fuad1502/open-running-watch-hw/models/1-2328702-0/3D/1-2328702-0.stp

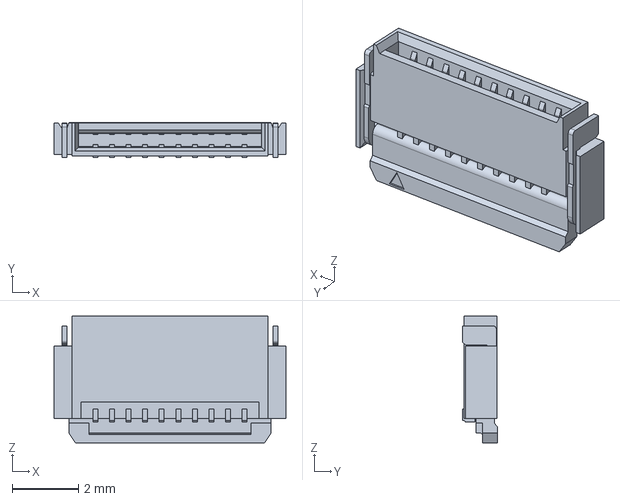
[picture p3: CAD file, 2024-04-13]
models/1-2328702-0/3D/1-2328702-0.stp
7.00 x 1.06 x 3.83 mm
