fuad1502/open-running-watch-hw/models/5029/3D/5029.stp

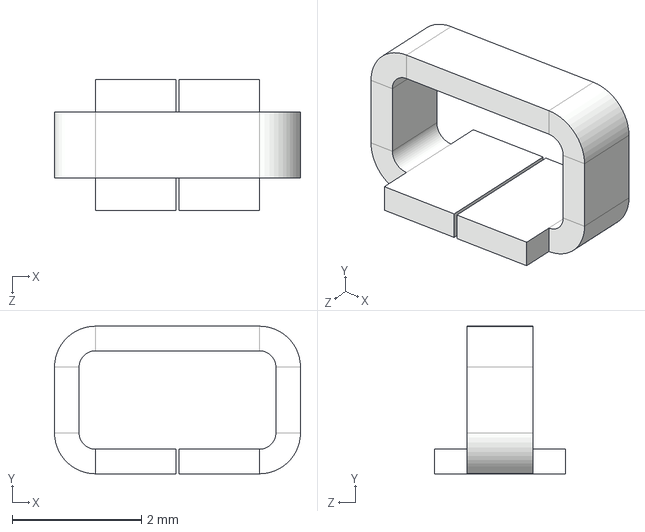
[picture p4: CAD file, 2024-04-12]
models/5029/3D/5029.stp
3.81 x 2.29 x 2.03 mm
