fuad1502/open-running-watch-hw/models/BALF-NRG-02D3/3D/BALF-NRG-02D3.stp

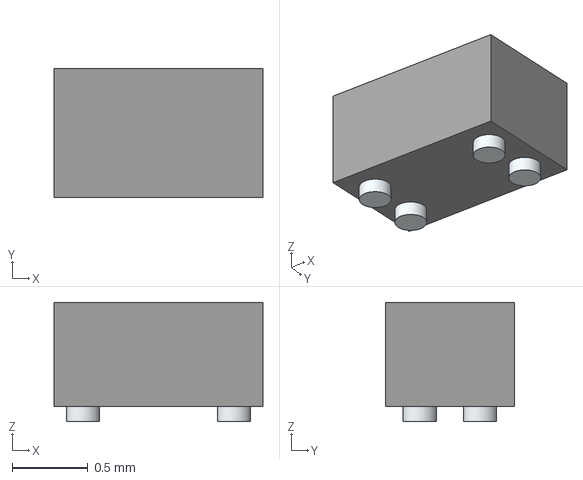
[picture p5: CAD file, 2024-04-12]
models/BALF-NRG-02D3/3D/BALF-NRG-02D3.stp
1.38 x 0.855 x 0.79 mm
Pins
