fuad1502/open-running-watch-hw/models/BAS16LT3G/3D/BAS16LT3G.stp

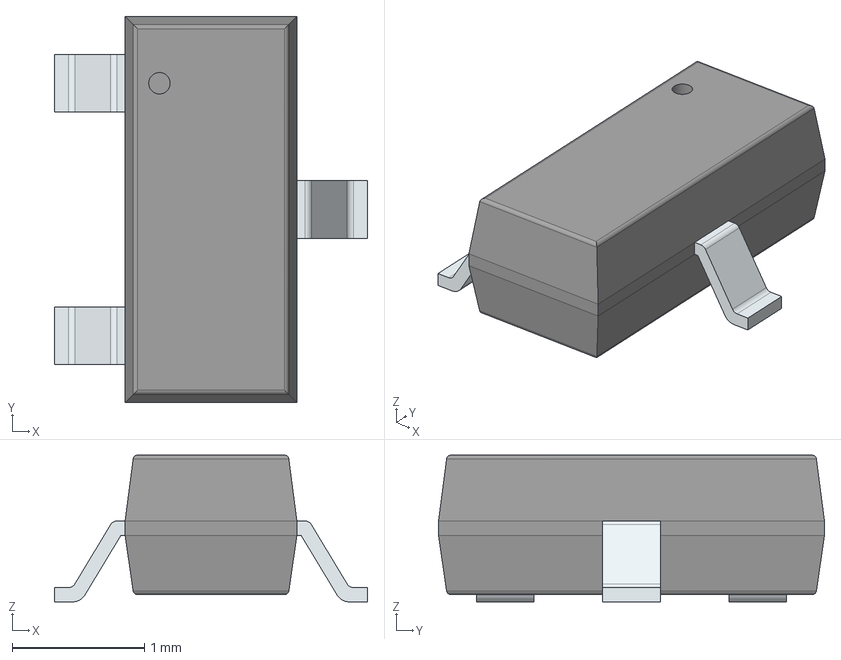
[picture p6: CAD file, 2024-04-12]
models/BAS16LT3G/3D/BAS16LT3G.stp
2.37 x 2.92 x 1.11 mm
PinsArrayL
FilletPinR
