fuad1502/open-running-watch-hw/models/BC817-25-QVL/3D/BC817-25-QVL.stp

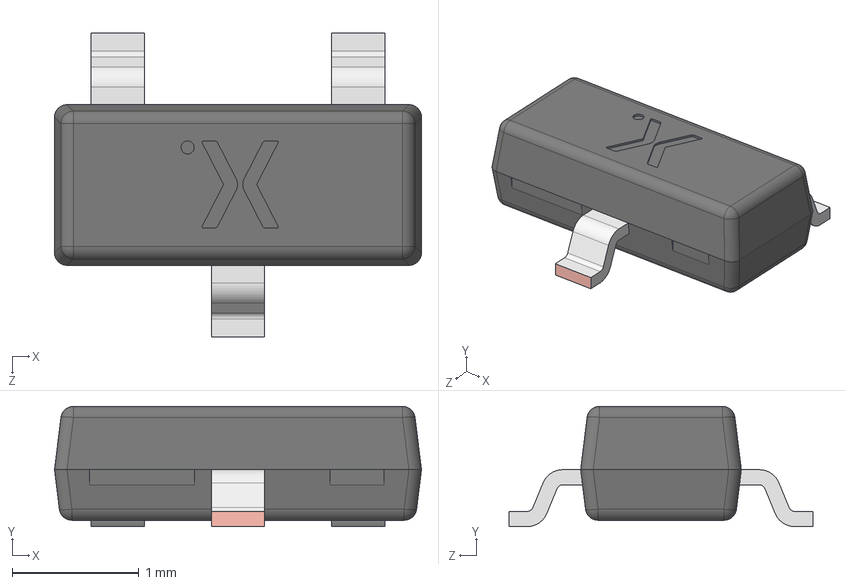
[picture p7: CAD file, 2024-04-12]
models/BC817-25-QVL/3D/BC817-25-QVL.stp
2.90 x 0.95 x 2.40 mm
SOT23 lower body
SOT23 Lead x 3
SOT23 Upper body
