fuad1502/open-running-watch-hw/models/BGA_725L6_E6327/3D/BGA_725L6_E6327.stp

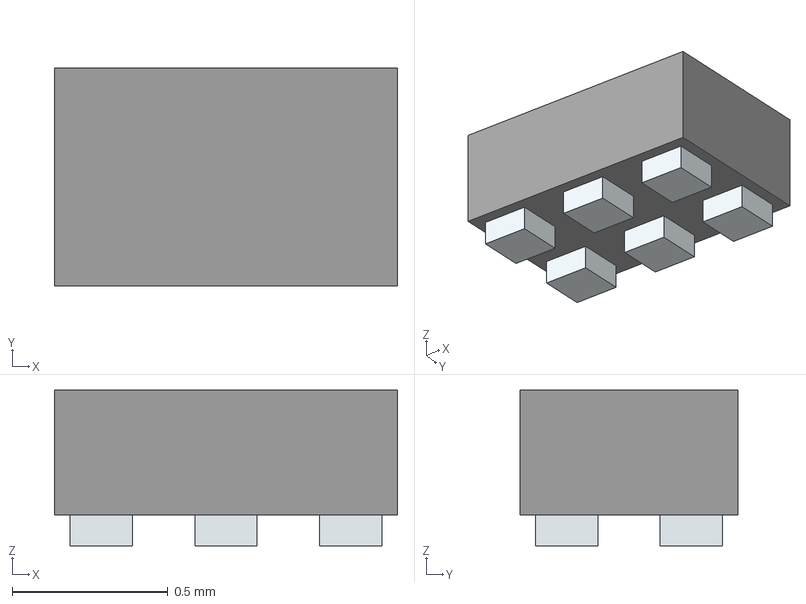
[picture p8: CAD file, 2024-04-12]
models/BGA_725L6_E6327/3D/BGA_725L6_E6327.stp
1.10 x 0.7 x 0.5 mm
Pins
