fuad1502/open-running-watch-hw/models/BLUENRG-232N/3D/BLUENRG-232N.stp

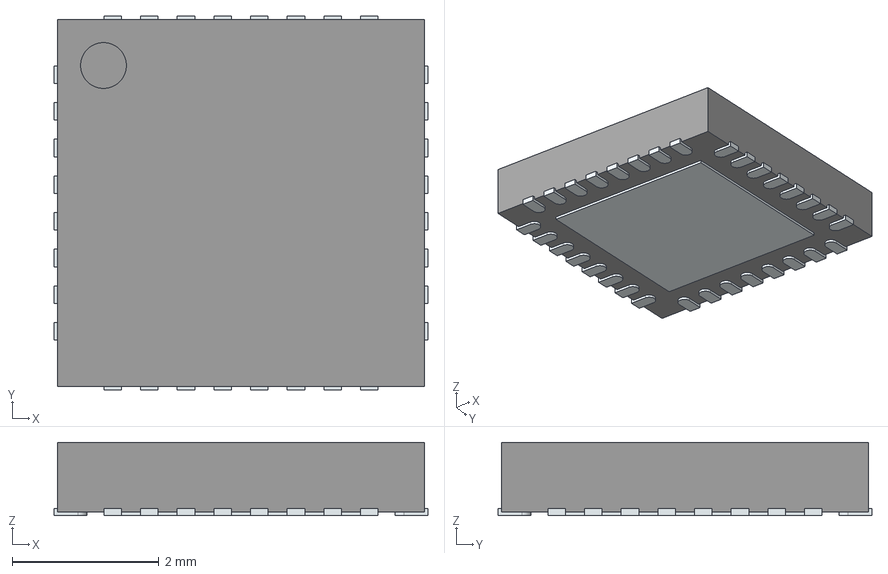
[picture p9: CAD file, 2024-04-12]
models/BLUENRG-232N/3D/BLUENRG-232N.stp
5.10 x 5.10 x 1.00 mm
ThermalPin
PinsArrayLR
PinsArrayTB
