fuad1502/open-running-watch-hw/models/CMT-7525-80-SMT-TR/3D/CMT-7525-80-SMT-TR.stp

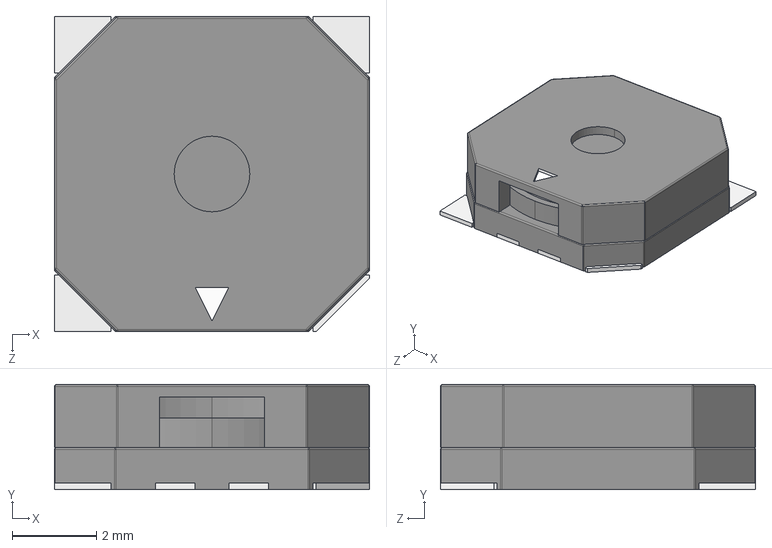
[picture p10: CAD file, 2024-04-12]
models/CMT-7525-80-SMT-TR/3D/CMT-7525-80-SMT-TR.stp
7.50 x 2.50 x 7.50 mm
