fuad1502/open-running-watch-hw/models/ECS-.327-7-1210-TR/3D/ECS-.327-7-1210-TR.stp

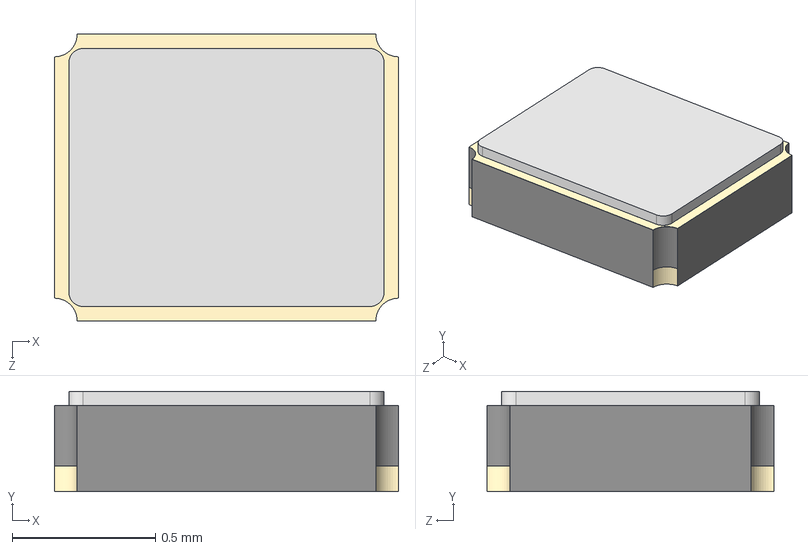
[picture p11: CAD file, 2024-04-12]
models/ECS-.327-7-1210-TR/3D/ECS-.327-7-1210-TR.stp
1.20 x 0.35 x 1.00 mm
