fuad1502/open-running-watch-hw/models/ECS-320-12-37B2-7KM-TR/3D/ECS-320-12-37B2-7KM-TR.stp

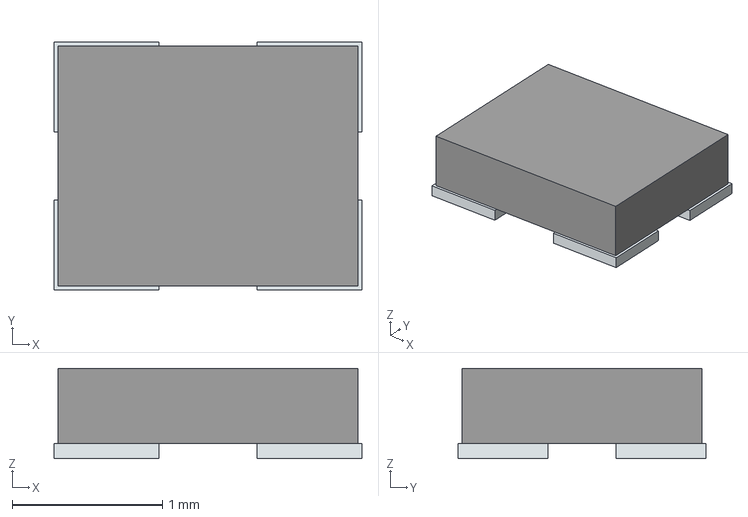
[picture p12: CAD file, 2024-04-12]
models/ECS-320-12-37B2-7KM-TR/3D/ECS-320-12-37B2-7KM-TR.stp
2.05 x 1.65 x 0.6 mm
Pins
