fuad1502/open-running-watch-hw/models/EVQ-P7J01P/3D/EVQ-P7J01P.stp

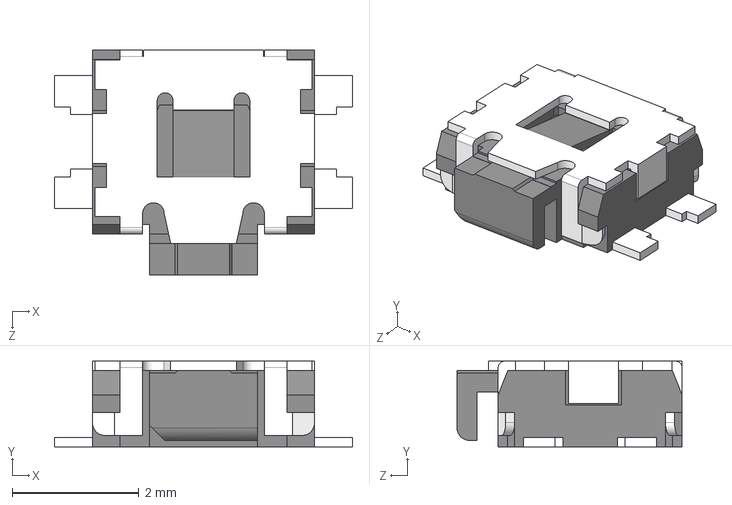
[picture p13: CAD file, 2024-04-13]
models/EVQ-P7J01P/3D/EVQ-P7J01P.stp
4.70 x 1.35 x 3.55 mm
