fuad1502/open-running-watch-hw/models/INA186A5IYFDR/3D/INA186A5IYFDR.stp

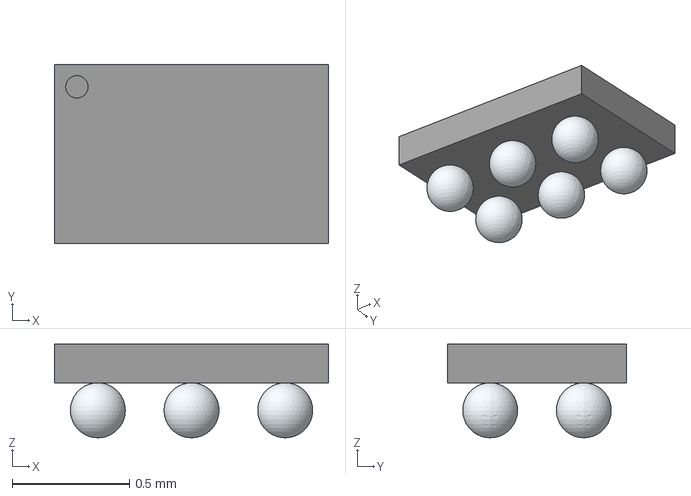
[picture p14: CAD file, 2024-04-12]
models/INA186A5IYFDR/3D/INA186A5IYFDR.stp
1.17 x 0.765 x 0.4 mm
