fuad1502/open-running-watch-hw/models/LIS2DE12TR/3D/LIS2DE12TR.stp

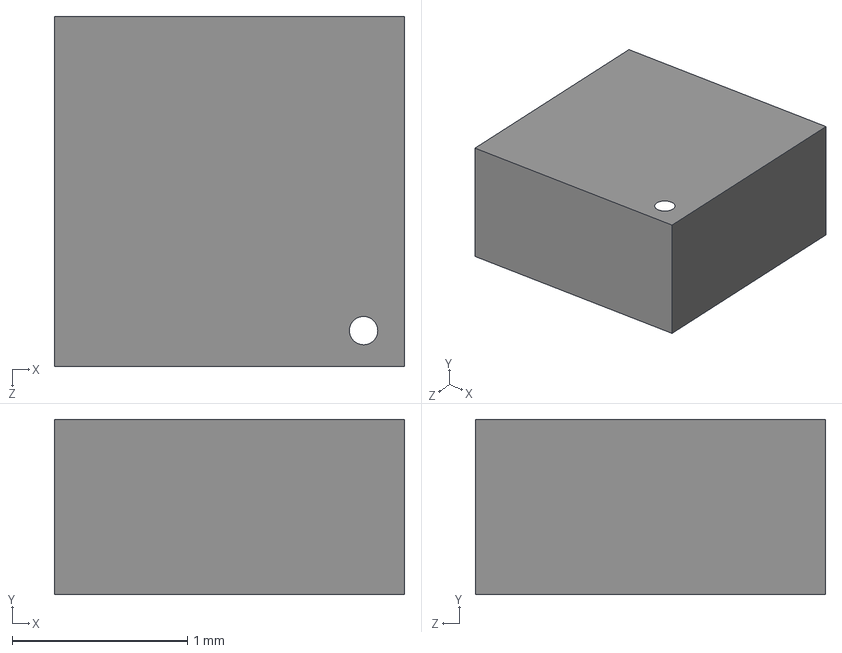
[picture p15: CAD file, 2024-04-12]
models/LIS2DE12TR/3D/LIS2DE12TR.stp
2.00 x 1 x 2.00 mm
