fuad1502/open-running-watch-hw/models/NX3215SA-32.768K-EXS00A-MU00003/3D/NX3215SA-32.768K-EXS00A-MU00003.stp

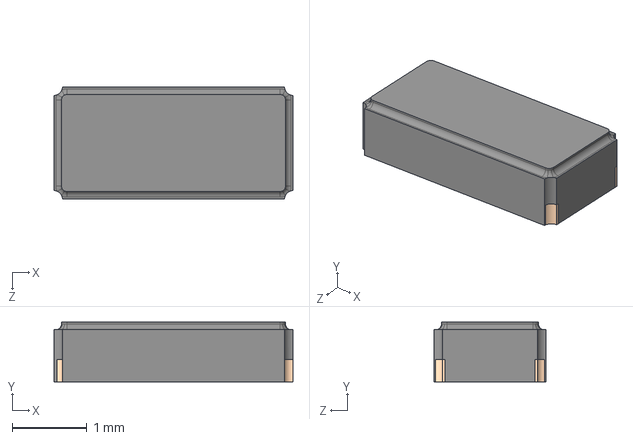
[picture p16: CAD file, 2024-04-12]
models/NX3215SA-32.768K-EXS00A-MU00003/3D/NX3215SA-32.768K-EXS00A-MU00003.stp
3.20 x 0.8 x 1.50 mm
