fuad1502/open-running-watch-hw/models/NXB0108BQX/3D/NXB0108BQX.stp

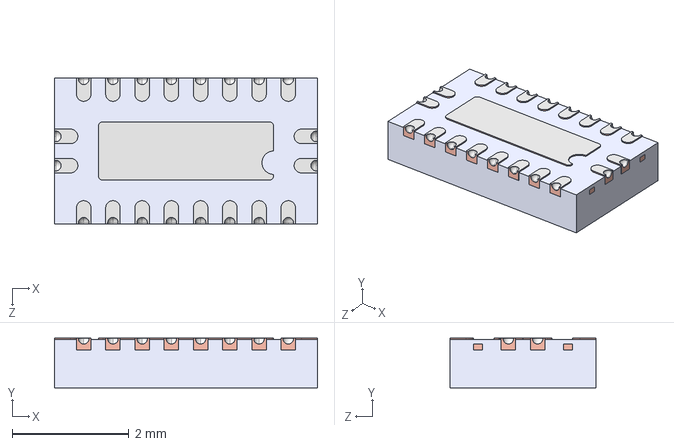
[picture p17: CAD file, 2024-04-12]
models/NXB0108BQX/3D/NXB0108BQX.stp
4.50 x 0.85 x 2.50 mm
SOT764-1 LF
SOT764-1 Mold Body
