fuad1502/open-running-watch-hw/models/PCAL9538ABSHP/3D/PCAL9538ABSHP.stp

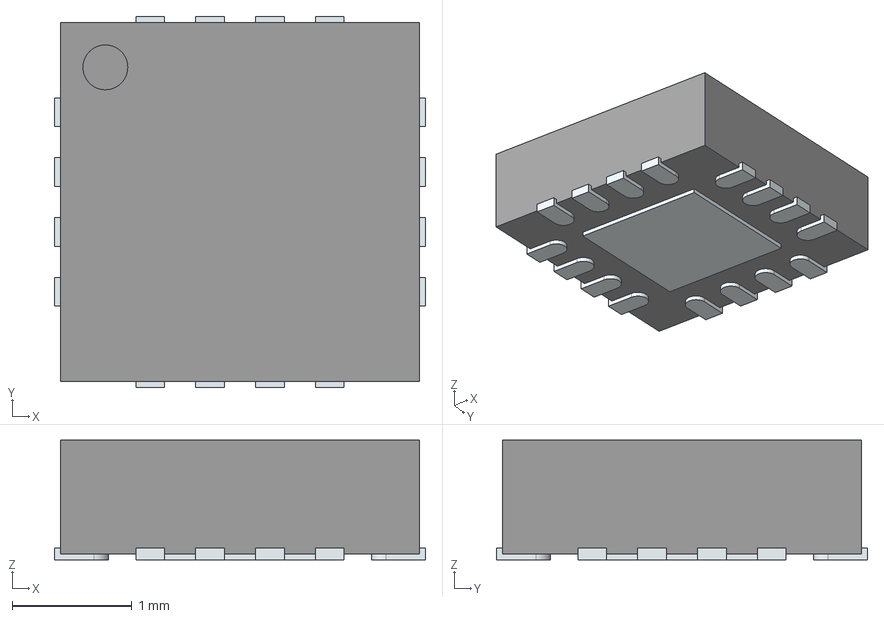
[picture p18: CAD file, 2024-04-17]
models/PCAL9538ABSHP/3D/PCAL9538ABSHP.stp
3.10 x 3.10 x 1.00 mm
ThermalPin
PinsArrayLR
PinsArrayTB
