fuad1502/open-running-watch-hw/models/PCS.55.A/3D/PCS.55.A.stp

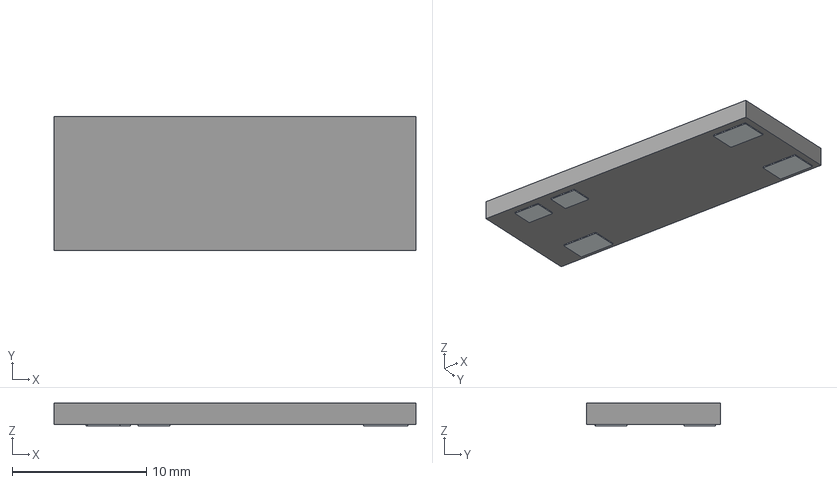
[picture p19: CAD file, 2024-04-12]
models/PCS.55.A/3D/PCS.55.A.stp
27.0 x 10.0 x 1.70 mm
Pins
