fuad1502/open-running-watch-hw/models/PMN280ENEAX/3D/PMN280ENEAX.stp

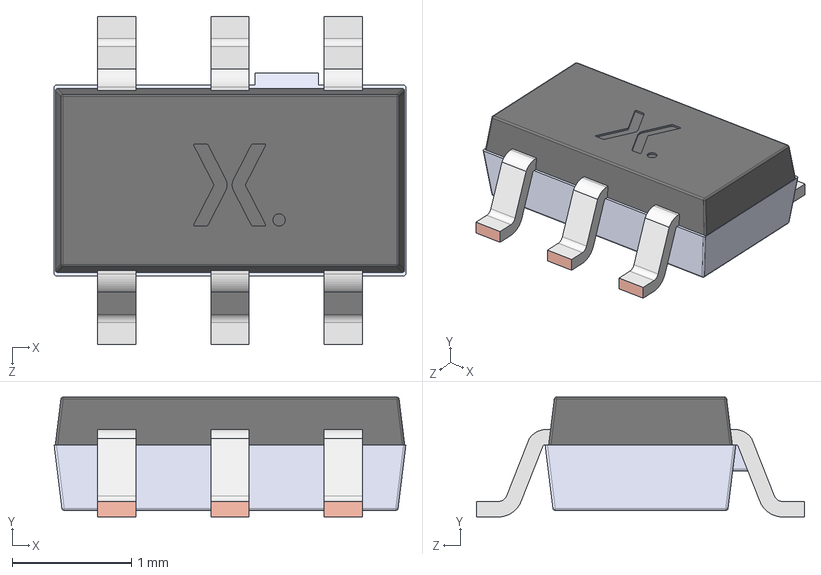
[picture p20: CAD file, 2024-05-13]
models/PMN280ENEAX/3D/PMN280ENEAX.stp
2.95 x 1.01 x 2.75 mm
SOT457 Lower body
SOT457 Lead x 6
SOT457 Upper body
