fuad1502/open-running-watch-hw/models/RKB2SJM250SMTR_LFS/3D/RKB2SJM250SMTR_LFS.stp

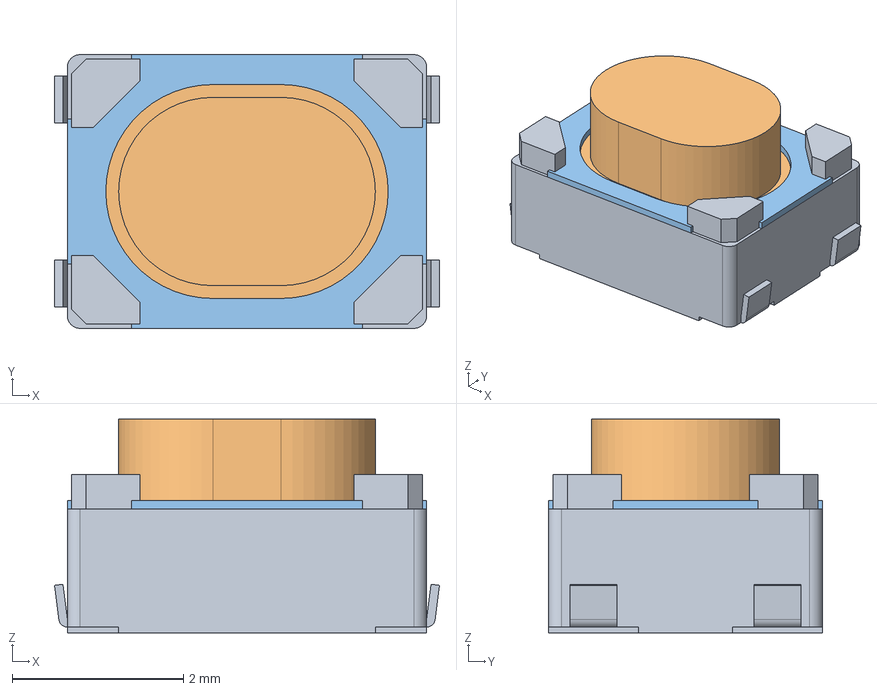
[picture p21: CAD file, 2024-04-12]
models/RKB2SJM250SMTR_LFS/3D/RKB2SJM250SMTR_LFS.stp
4.50 x 3.20 x 2.50 mm
JIZUO
ANNIU
GAIBAN
