fuad1502/open-running-watch-hw/models/SFH_7072/3D/SFH_7072.stp

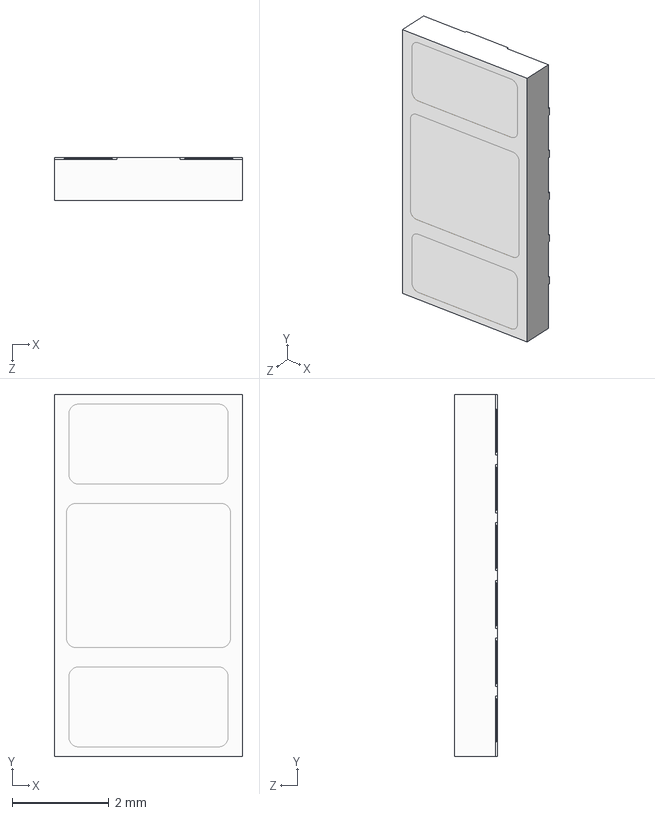
[picture p22: CAD file, 2024-04-12]
models/SFH_7072/3D/SFH_7072.stp
3.90 x 7.50 x 0.9 mm
