fuad1502/open-running-watch-hw/models/SM02B-SRSS-TB/SM02B-SRSS-TB_LF__SN_.step

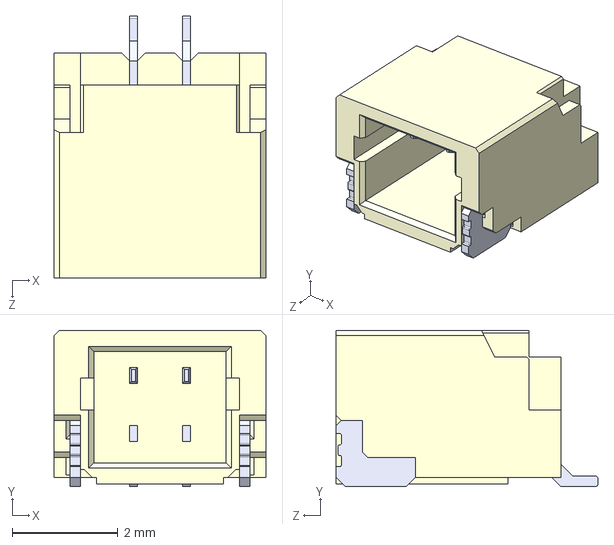
[picture p23: CAD file, 2024-04-12]
models/SM02B-SRSS-TB/SM02B-SRSS-TB_LF__SN_.step
4.00 x 2.95 x 4.95 mm
