fuad1502/open-running-watch-hw/models/ST1S15J18R/3D/ST1S15J18R.stp

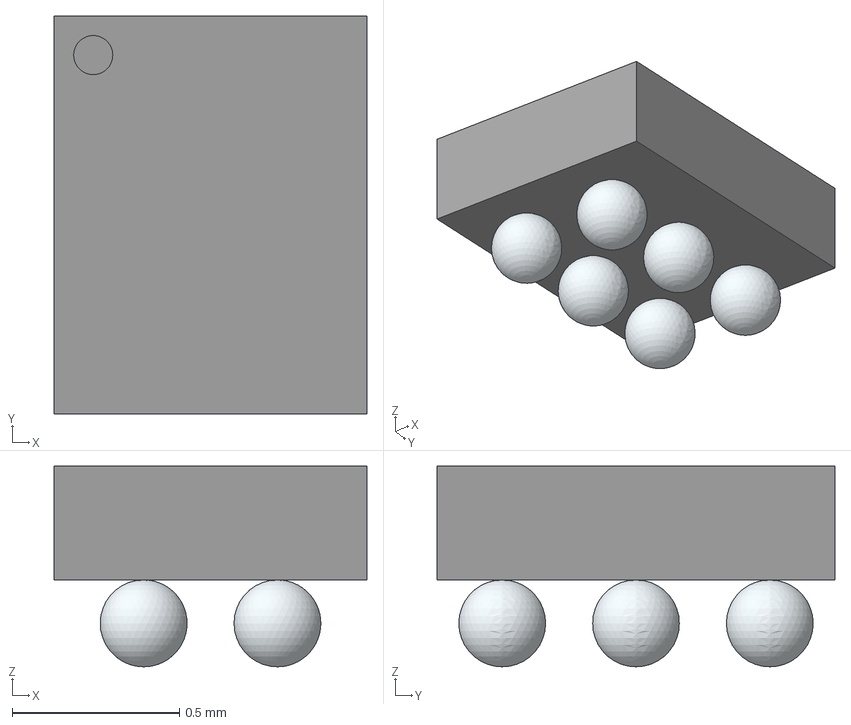
[picture p24: CAD file, 2024-04-12]
models/ST1S15J18R/3D/ST1S15J18R.stp
0.935 x 1.19 x 0.6 mm
