fuad1502/open-running-watch-hw/models/STM32L475RGT6/3D/STM32L475RGT6.stp

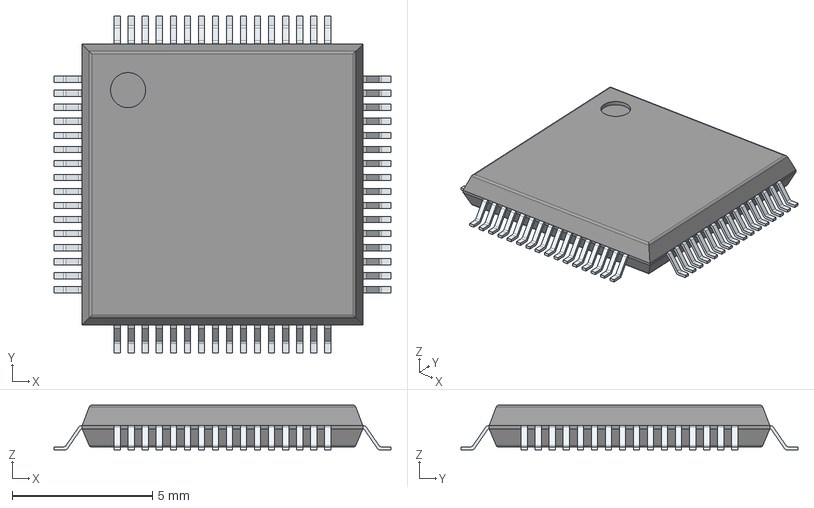
[picture p25: CAD file, 2024-04-12]
models/STM32L475RGT6/3D/STM32L475RGT6.stp
12.0 x 12.0 x 1.60 mm
PinsArrayLR
PinsArrayTB
