fuad1502/open-running-watch-hw/models/TESEO-LIV3F/3D/TESEO-LIV3F.stp

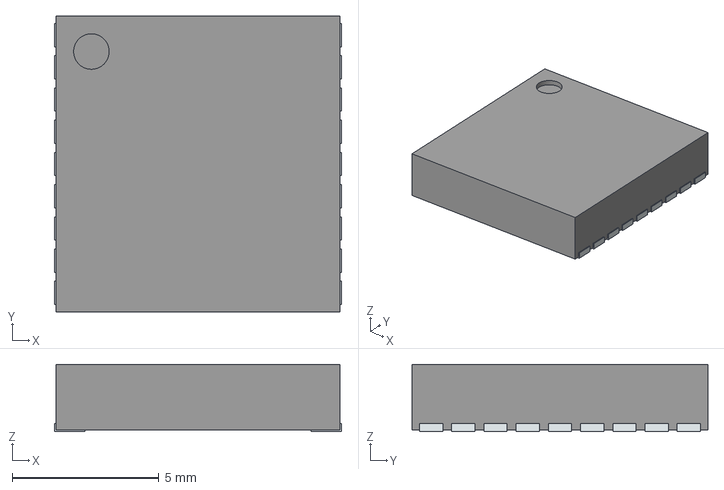
[picture p26: CAD file, 2024-04-12]
models/TESEO-LIV3F/3D/TESEO-LIV3F.stp
9.80 x 10.1 x 2.30 mm
PinsArrayLR
