fuad1502/open-running-watch-hw/models/TL3336AF160Q/3D/TL3336AF160Q.stp

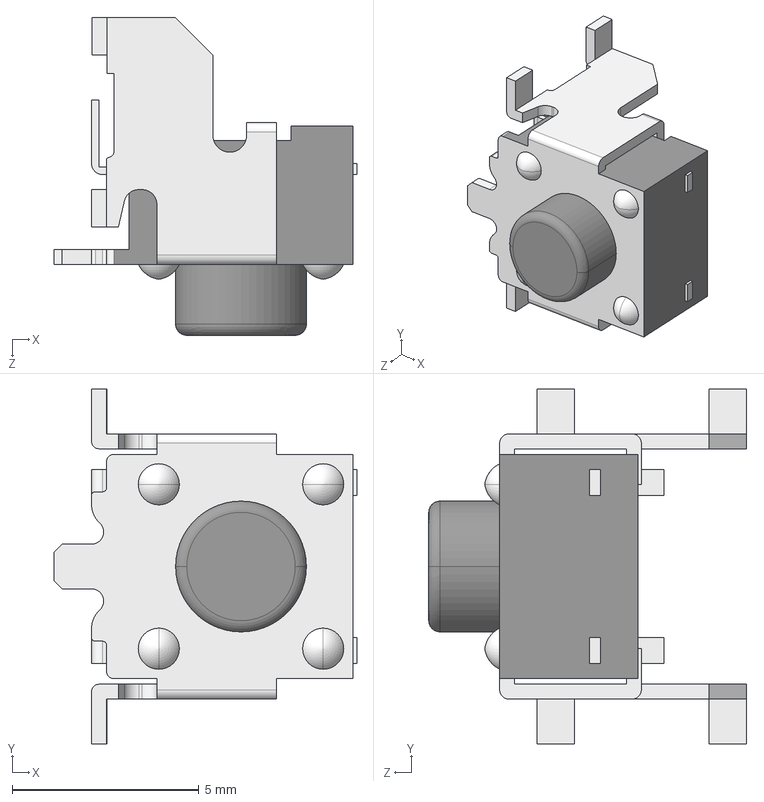
[picture p27: CAD file, 2024-04-12]
models/TL3336AF160Q/3D/TL3336AF160Q.stp
8.10 x 9.50 x 8.50 mm
