fuad1502/open-running-watch-hw/models/TLV9002SIRUGR/3D/TLV9002SIRUGR.stp

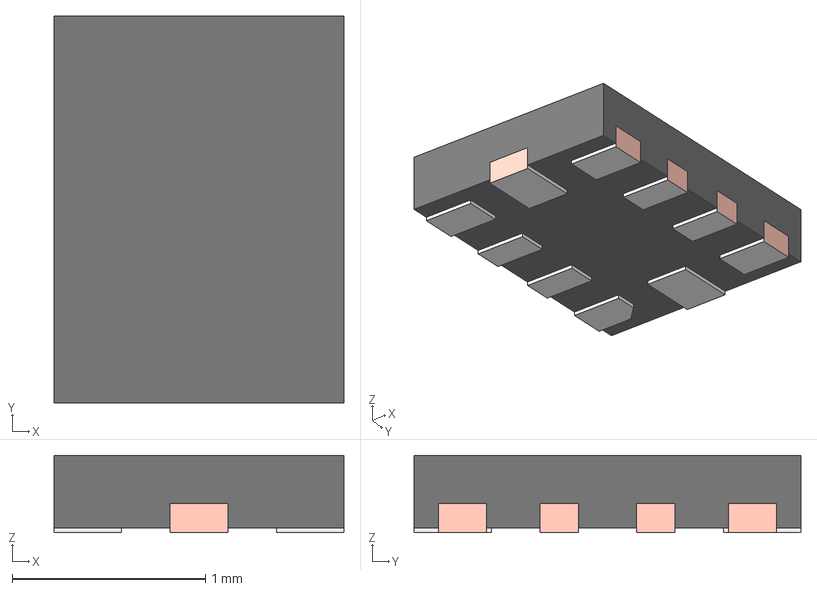
[picture p28: CAD file, 2024-04-12]
models/TLV9002SIRUGR/3D/TLV9002SIRUGR.stp
1.50 x 2.00 x 0.4 mm
FRAME_RUG0010A
BODY_RUG0010A
