fuad1502/open-running-watch-hw/models/W25N512GVEIG/3D/W25N512GVEIG.stp

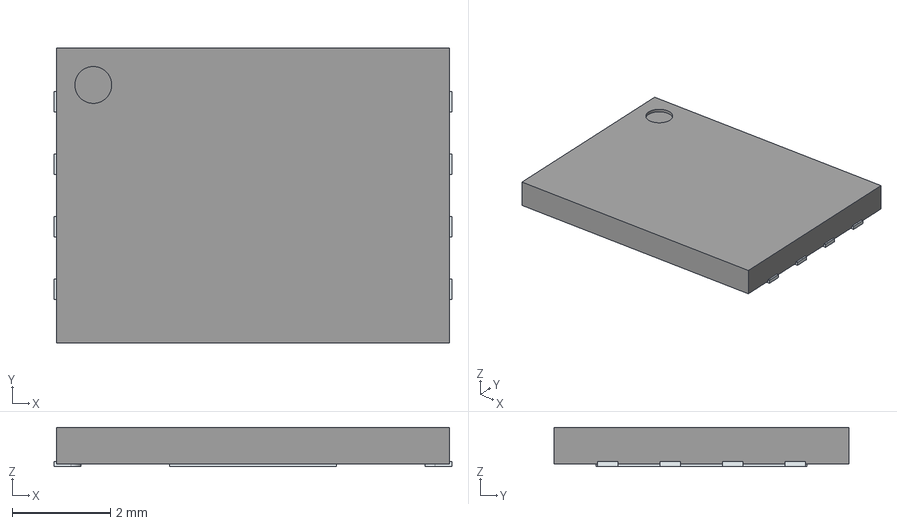
[picture p29: CAD file, 2024-04-12]
models/W25N512GVEIG/3D/W25N512GVEIG.stp
8.10 x 6.00 x 0.8 mm
ThermalPin
PinsArrayLR
