fuad1502/open-running-watch-hw/models/WLA.04/3D/WLA.04.stp

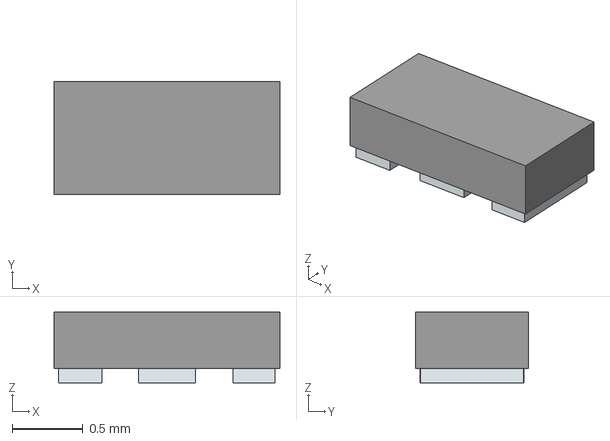
[picture p30: CAD file, 2024-04-12]
models/WLA.04/3D/WLA.04.stp
1.60 x 0.8 x 0.5 mm
Pins
