fuad1502/open-running-watch-hw/(list of files, cad)

Other CAD files:
models/10118192-0001LF/3D/10118192-0001LF.stp
models/12616-06/12616-06_T3_prelim_02-04-2021.STEP
models/20021121-00014T4LF/3D/20021121-00014T4LF--3DModel-STEP-56544.STEP
models/20021121-00014T4LF/3D/20021121-00014T4LF.stp
models/2328702-4/3D/2328702-4.stp
models/505110-1492/3D/505110-1492.stp
models/B39162B4327P810/B39162B4327P810.step
models/BQ27441DRZR-G1A/3D/BQ27441DRZR-G1A.stp
models/JS102011JCQN/3D/JS102011JCQN.stp
models/MCP73811T-420I_OT/3D/MCP73811T-420I_OT.stp
models/MIC23050-SYML-TR/3D/MIC23050-SYML-TR.stp
models/TPS613222ADBVR/3D/TPS613222ADBVR.stp
models/TPS62237DRYR/3D/TPS62237DRYR.stp
