fuad1502/open-running-watch-hw/open-running-watch.kicad_pcb

## KiCad design open-running-watch.kicad_pcb (2024-05-13)

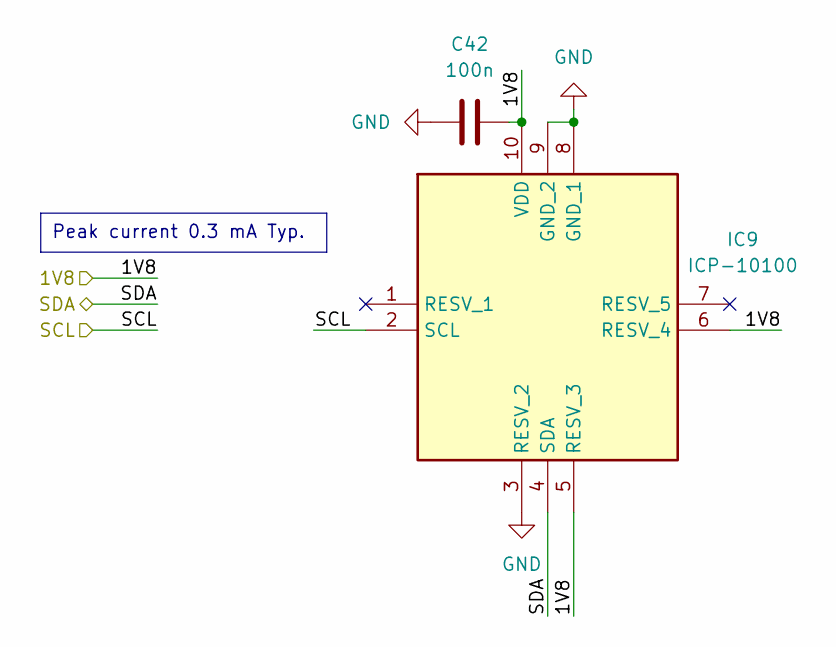
[picture p31: schematic barometer.kicad_sch, Open Running Watch]

Parts:
C42: 100n; C_0402_1005Metric; Manufacturer_Part_Number GRM155R71A104MA01D
IC9: ICP-10100; ICP10100; Mouser Part Number 410-ICP-10100

Connections:
/barometer/SCL: IC9.2 (SCL); also elsewhere on the board
/barometer/SDA: IC9.4 (SDA); also elsewhere on the board
GND: C42.1, IC9.3 (RESV_2), IC9.8 (GND_1), IC9.9 (GND_2); also elsewhere on the board

Notes on the sheet:
Peak current 0.3 mA Typ.

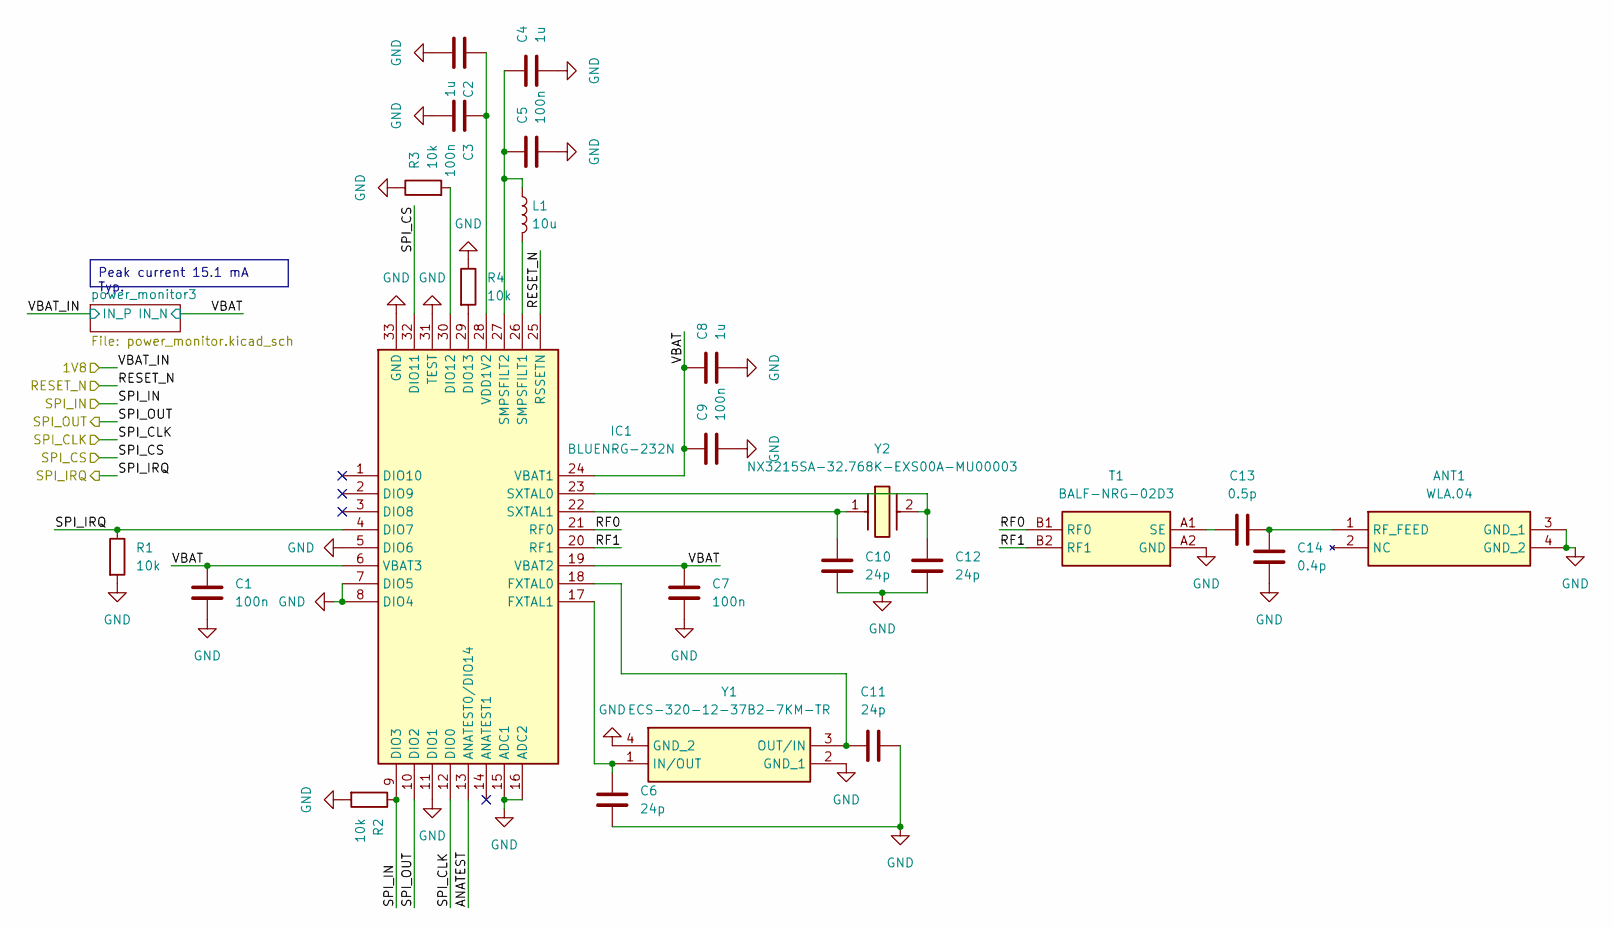
[picture p32: schematic bluenrg.kicad_sch, Open Running Watch]

Parts:
ANT1: WLA.04; WLA04; Mouser Part Number 960-WLA.04
C1, C3, C5, C7, C9: 100n; C_0402_1005Metric; Manufacturer_Part_Number GRM155R71A104MA01D
C2, C4, C8: 1u; C_0603_1608Metric; Manufacturer_Part_Number C0603C105K4RACTU
C6, C10, C11, C12: 24p; C_0402_1005Metric; Manufacturer_Part_Number GRT1555C1H240FA02D
C13: 0.5p; C_0402_1005Metric; Manufacturer_Part_Number GCQ1555C1HR50CB01D
C14: 0.4p; C_0402_1005Metric; Manufacturer_Part_Number GCQ1555C1HR40CB01D
IC1: BLUENRG-232N; QFN50P500X500X100-33N-D; Mouser Part Number 511-BLUENRG-232N
L1: 10u; L_0805_2012Metric; Manufacturer_Part_Number MLZ2012N100LT000
R1, R2, R3, R4: 10k; R_0402_1005Metric; Manufacturer_Part_Number RC0402JR-0710KP
T1: BALF-NRG-02D3; BALFNRG02D3; Mouser Part Number 511-BALF-NRG-02D3
Y1: ECS-320-12-37B2-7KM-TR; ECS3201237B27KMTR; Mouser Part Number 520-320-12-37B27KMTR
Y2: NX3215SA-32.768K-EXS00A-MU00003; NX3215SA32768KEXS00AMU00003; Mouser Part Number 344-NX3215SA32.768K3

Connections:
/accelerometer/SDIO: IC1.9 (DIO3), R2.1; also elsewhere on the board
/accelerometer/SDO: IC1.10 (DIO2); also elsewhere on the board
/accelerometer/SPC: IC1.12 (DIO0); also elsewhere on the board
/bluenrg/ANATEST: IC1.13 (ANATEST0/DIO14)
/bluenrg/RESET_N: IC1.25 (RSSETN); also elsewhere on the board
/bluenrg/RF0: IC1.21 (RF0), T1.B1 (RF0)
/bluenrg/RF1: IC1.20 (RF1), T1.B2 (RF1)
/bluenrg/SPI_CS: IC1.32 (DIO11); also elsewhere on the board
/bluenrg/SPI_IRQ: IC1.4 (DIO7), R1.1; also elsewhere on the board
GND: ANT1.3 (GND_1), ANT1.4 (GND_2), C1.2, C2.2, C3.2, C4.2, C5.2, C6.2, C7.2, C8.2, C9.2, C10.2, C11.2, C12.2, C14.2, IC1.5 (DIO6), IC1.7 (DIO5), IC1.8 (DIO4), IC1.11 (DIO1), IC1.15 (ADC1), IC1.16 (ADC2), IC1.31 (TEST), IC1.33 (GND), R1.2, R2.2, R3.1, R4.1, T1.A2 (GND), Y1.2 (GND_1), Y1.4 (GND_2); also elsewhere on the board
unnamed: ANT1.1 (RF_FEED), C13.2, C14.1
unnamed: IC1.30 (DIO12), R3.2
unnamed: IC1.29 (DIO13), R4.2
unnamed: C11.1, IC1.18 (FXTAL0), Y1.3 (OUT/IN)
unnamed: C6.1, IC1.17 (FXTAL1), Y1.1 (IN/OUT)
unnamed: IC1.26 (SMPSFILT1), L1.2
unnamed: C4.1, C5.1, IC1.27 (SMPSFILT2), L1.1
unnamed: C12.1, IC1.23 (SXTAL0), Y2.2
unnamed: C10.1, IC1.22 (SXTAL1), Y2.1
unnamed: C2.1, C3.1, IC1.28 (VDD1V2)
unnamed: C13.1, T1.A1 (SE)

Notes on the sheet:
Peak current 15.1 mA Typ.

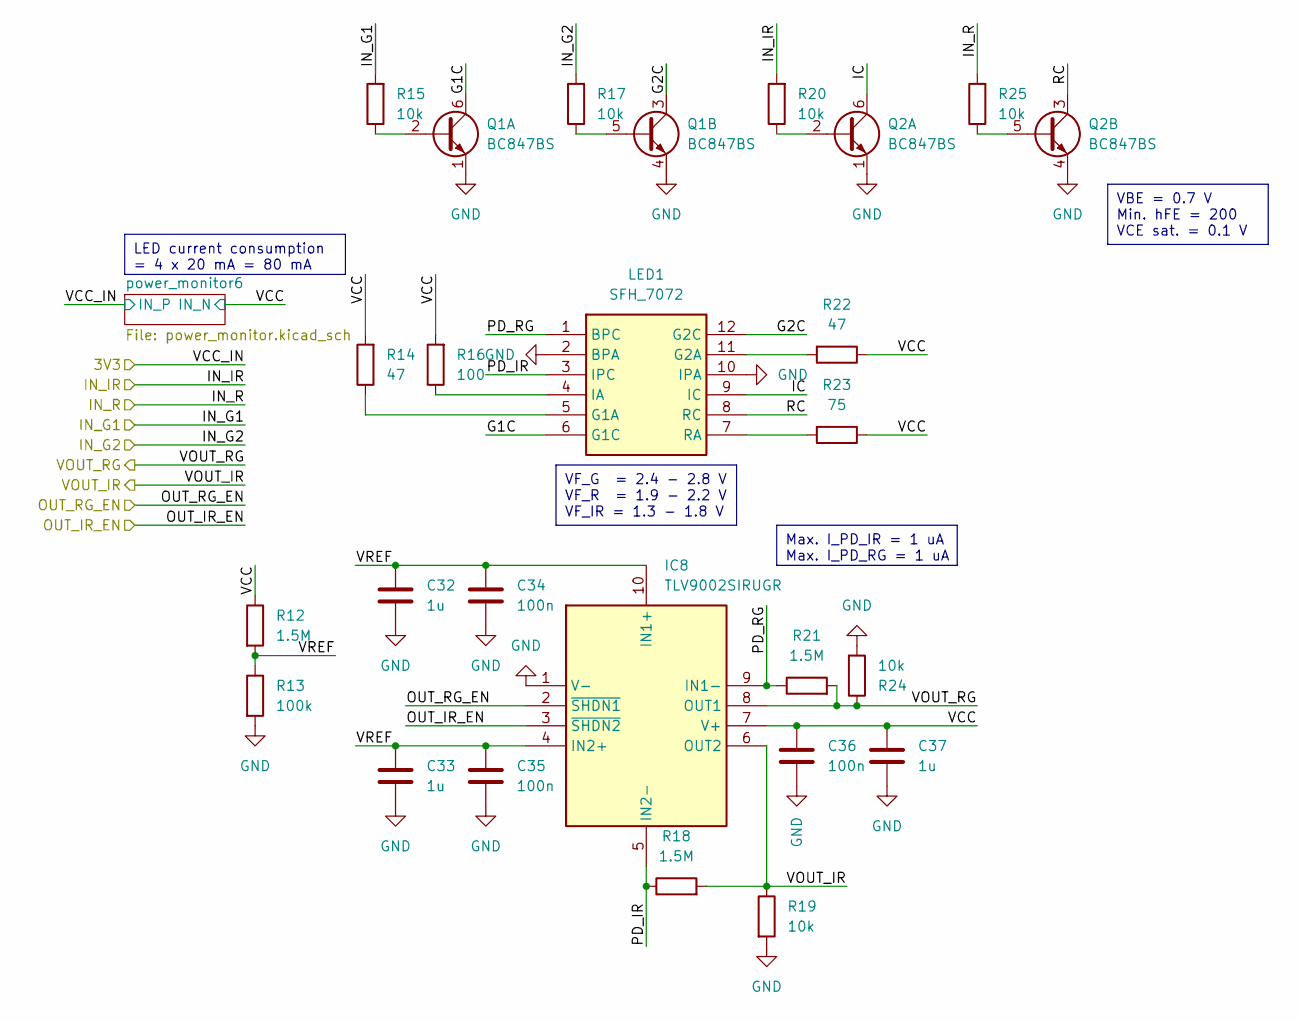
[picture p33: schematic biometric.kicad_sch, Open Running Watch]

Parts:
C32, C33, C37: 1u; C_0603_1608Metric; Manufacturer_Part_Number C0603C105K4RACTU
C34, C35, C36: 100n; C_0402_1005Metric; Manufacturer_Part_Number GRM155R71A104MA01D
IC8: TLV9002SIRUGR; QFN50P150X200X40-10N; Mouser Part Number 595-TLV9002SIRUGR
LED1: SFH_7072; SFH7072; Mouser Part Number 720-SFH7072
Q1, Q2: BC847BS; SOT-363_SC-70-6; Manufacturer_Part_Number BC847BS,135
R12, R18, R21: 1.5M; R_0402_1005Metric; Manufacturer_Part_Number AC0402FR-071M5L
R13: 100k; R_0402_1005Metric; Manufacturer_Part_Number RC0402JR-7D100KL
R14, R22: 47; R_0402_1005Metric; Manufacturer_Part_Number RC0402JR-0747RL
R15, R17, R19, R20, R24, R25: 10k; R_0402_1005Metric; Manufacturer_Part_Number RC0402JR-0710KP
R16: 100; R_0402_1005Metric; Manufacturer_Part_Number AC0402FR-13100RL
R23: 75; R_0402_1005Metric; Manufacturer_Part_Number RC0402JR-0775RL

Connections:
/biometric/G1C: LED1.6 (G1C), Q1.6 (C1)
/biometric/G2C: LED1.12 (G2C), Q1.3 (C2)
/biometric/IC: LED1.9 (IC), Q2.6 (C1)
/biometric/IN_G1: R15.2; also elsewhere on the board
/biometric/IN_G2: R17.2; also elsewhere on the board
/biometric/IN_IR: R20.2; also elsewhere on the board
/biometric/IN_R: R25.2; also elsewhere on the board
/biometric/OUT_IR_EN: IC8.2 (~SHDN1), IC8.3 (~SHDN2); also elsewhere on the board
/biometric/PD_IR: IC8.5 (IN2-), LED1.3 (IPC), R18.1
/biometric/PD_RG: IC8.9 (IN1-), LED1.1 (BPC), R21.1
/biometric/RC: LED1.8 (RC), Q2.3 (C2)
/biometric/VCC: C36.1, C37.1, IC8.7 (V+), R12.1, R14.2, R16.2, R22.1, R23.1; also elsewhere on the board
/biometric/VOUT_IR: IC8.6 (OUT2), R18.2, R19.1; also elsewhere on the board
/biometric/VOUT_RG: IC8.8 (OUT1), R21.2, R24.1; also elsewhere on the board
/biometric/VREF: C32.1, C33.1, C34.1, C35.1, IC8.4 (IN2+), IC8.10 (IN1+), R12.2, R13.1
GND: C32.2, C33.2, C34.2, C35.2, C36.2, C37.2, IC8.1 (V-), LED1.2 (BPA), LED1.10 (IPA), Q1.1 (E1), Q1.4 (E2), Q2.1 (E1), Q2.4 (E2), R13.2, R19.2, R24.2; also elsewhere on the board
unnamed: LED1.5 (G1A), R14.1
unnamed: LED1.11 (G2A), R22.2
unnamed: LED1.4 (IA), R16.1
unnamed: LED1.7 (RA), R23.2
unnamed: Q1.2 (B1), R15.1
unnamed: Q1.5 (B2), R17.1
unnamed: Q2.2 (B1), R20.1
unnamed: Q2.5 (B2), R25.1

Notes on the sheet:
Max. I_PD_IR = 1 uA Max. I_PD_RG = 1 uA
LED current consumption = 4 x 20 mA = 80 mA
VF_G = 2.4 - 2.8 V VF_R = 1.9 - 2.2 V VF_IR = 1.3 - 1.8 V
VBE = 0.7 V Min. hFE = 200 VCE sat. = 0.1 V

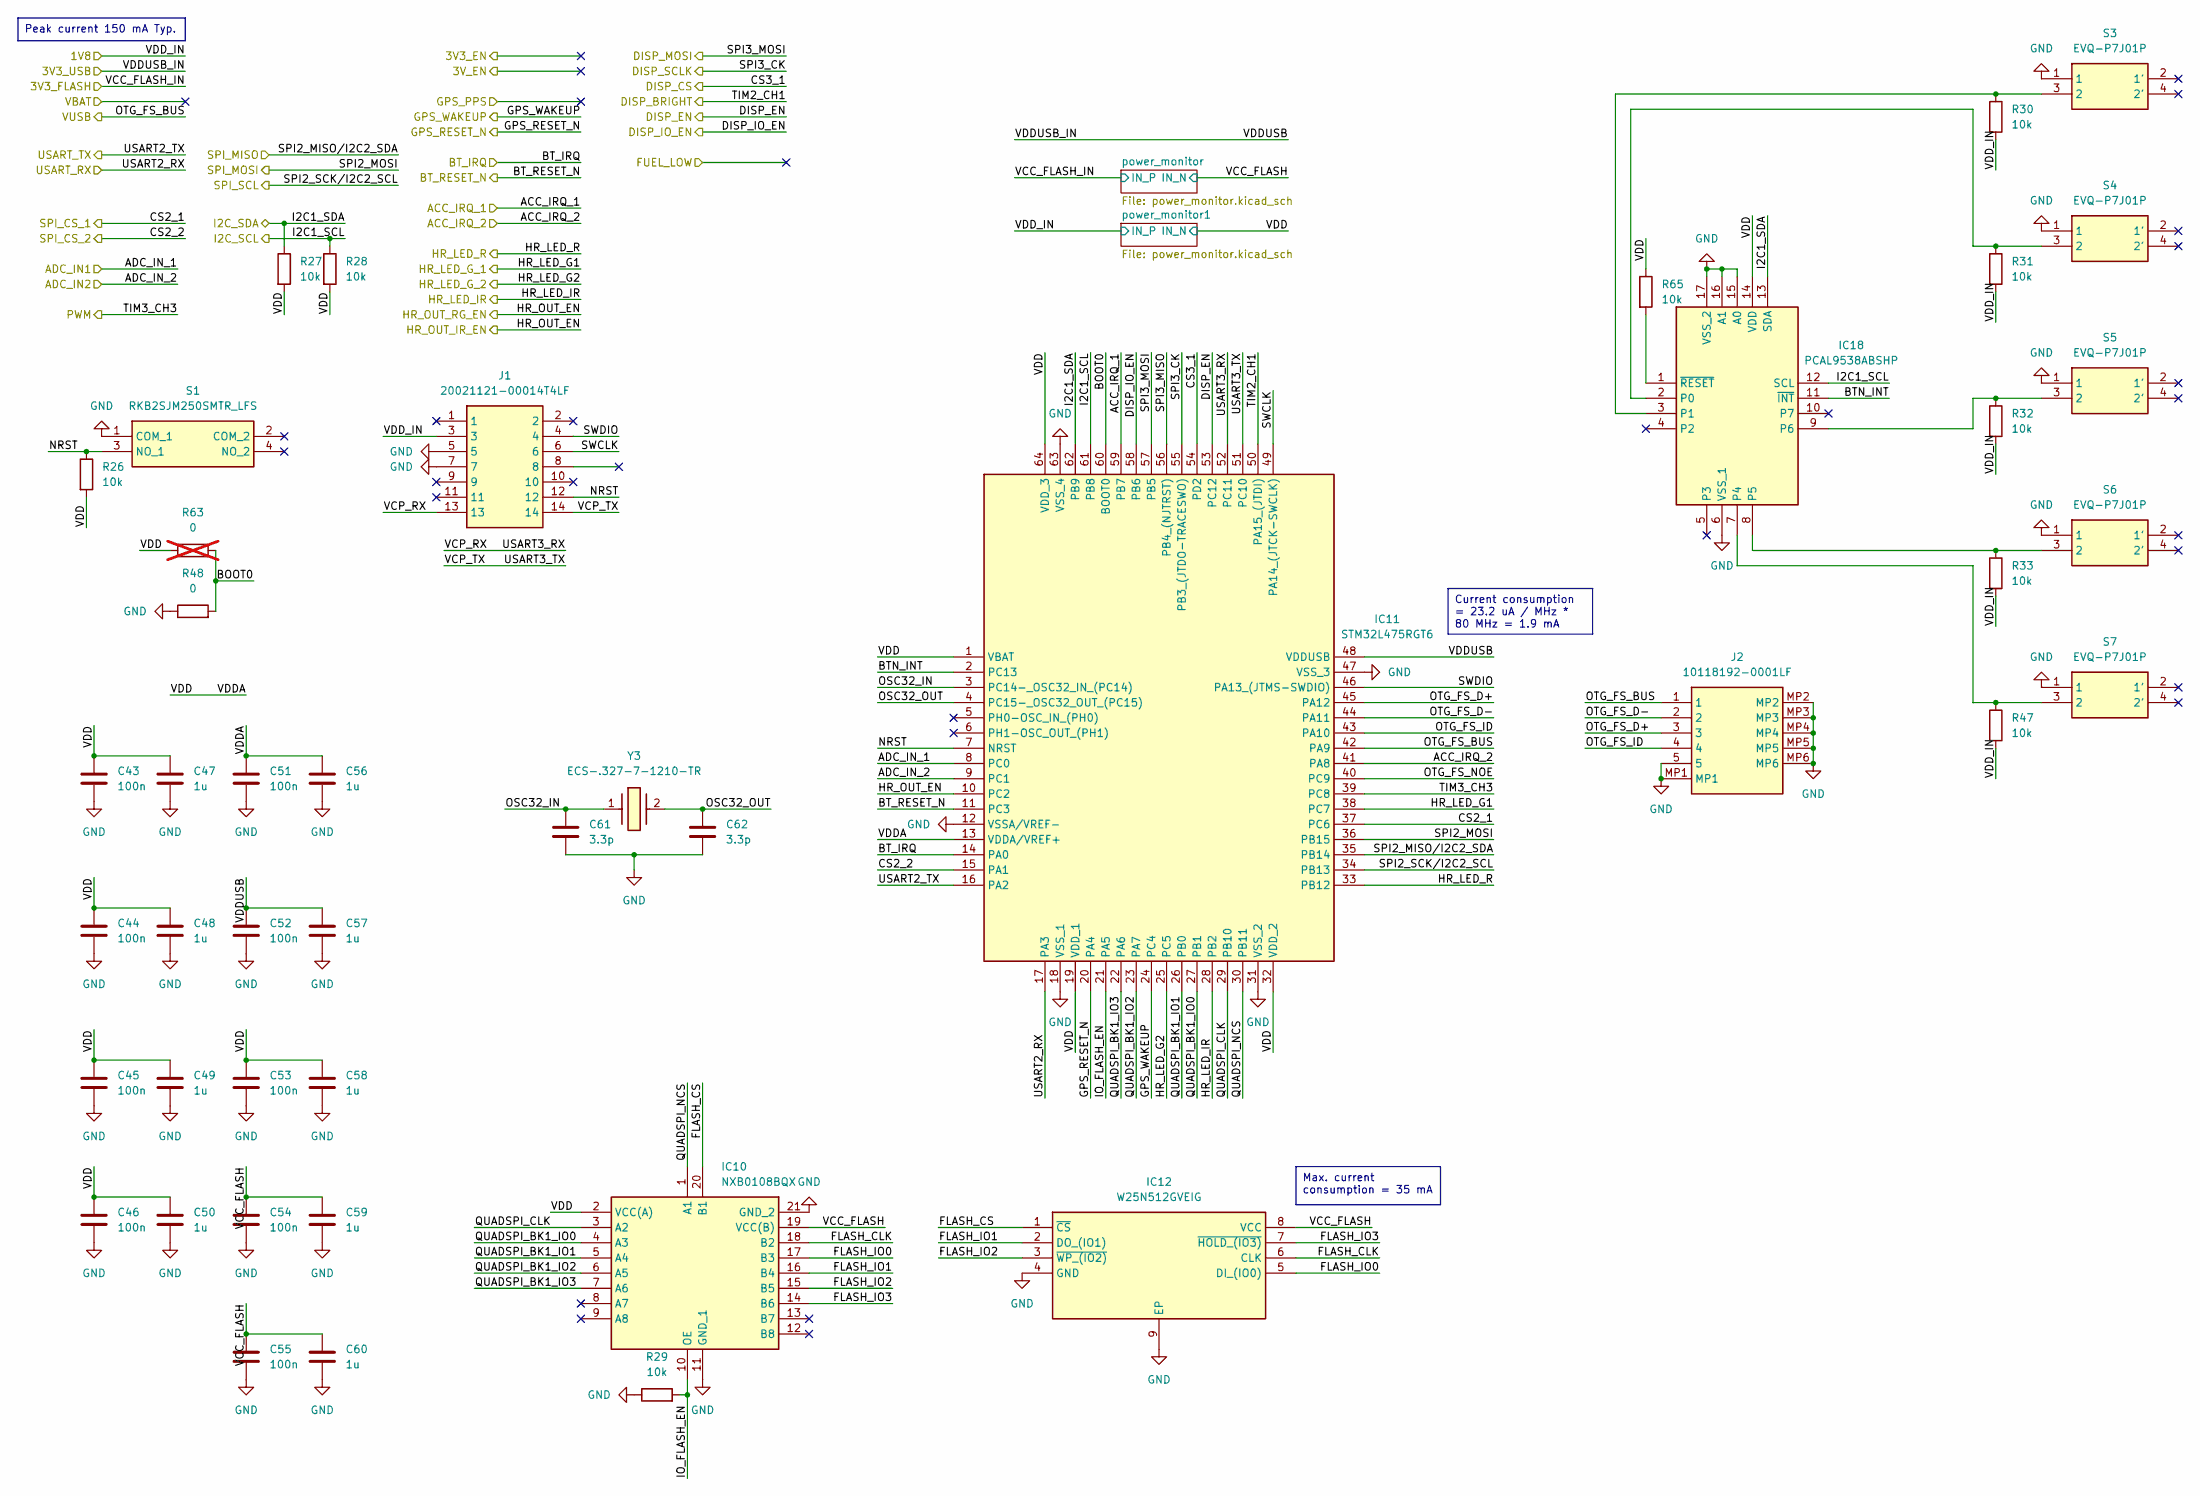
[picture p34: schematic controller.kicad_sch, Open Running Watch]

Parts:
C43, C44, C45, C46, C51, C52, C53, C54, C55: 100n; C_0402_1005Metric; Manufacturer_Part_Number GRM155R71A104MA01D
C47, C48, C49, C50, C56, C57, C58, C59, C60: 1u; C_0603_1608Metric; Manufacturer_Part_Number C0603C105K4RACTU
C61, C62: 3.3p; C_0402_1005Metric; Manufacturer_Part_Number GRM1555C1E3R3WA01D
IC10: NXB0108BQX; Mouser Part Number 771-NXB0108BQX
IC11: STM32L475RGT6; QFP50P1200X1200X160-64N; Mouser Part Number 511-STM32L475RGT6
IC12: W25N512GVEIG; SON127P800X600X80-9N-D; Mouser Part Number 454-W25N512GVEIG
IC18: PCAL9538ABSHP; QFN50P300X300X100-17N-D; Mouser Part Number 771-PCAL9538ABSHP
J1: 20021121-00014T4LF; 2002112100014T4LF; Mouser Part Number 649-221121-00014T4LF
J2: 10118192-0001LF; 101181920001LF; Manufacturer_Part_Number 10118192-0001LF
R26, R27, R28, R29, R30, R31, R32, R33, R47, R65: 10k; R_0402_1005Metric; Manufacturer_Part_Number RC0402JR-0710KP
R48: 0; R_0402_1005Metric_Pad0.72x0.64mm_HandSolder; Manufacturer_Part_Number AC0402JR-7D0RL
R63: 0; R_0402_1005Metric_Pad0.72x0.64mm_HandSolder; Manufacturer_Part_Number AC0402JR-7D0RL; not fitted
S1: RKB2SJM250SMTR_LFS; RKB2SJM250SMTRLFS; Mouser Part Number 611-RKB2SJM250SMTRLF
S3, S4, S5, S6, S7: EVQ-P7J01P; EVQP7J01P; Mouser Part Number 667-EVQP7J01P
Y3: ECS-.327-7-1210-TR; ECS32791210TR; Mouser Part Number 520-.327-7-1210T

Connections:
/accelerometer/CS: IC11.37 (PC6); also elsewhere on the board
/accelerometer/INT_1: IC11.59 (PB7); also elsewhere on the board
/accelerometer/INT_2: IC11.41 (PA8); also elsewhere on the board
/accelerometer/SDIO: IC11.36 (PB15); also elsewhere on the board
/accelerometer/SDO: IC11.35 (PB14); also elsewhere on the board
/accelerometer/SPC: IC11.34 (PB13); also elsewhere on the board
/audio/IN: IC11.39 (PC8); also elsewhere on the board
/barometer/SCL: IC11.61 (PB8), IC18.12 (SCL), R28.1; also elsewhere on the board
/barometer/SDA: IC11.62 (PB9), IC18.13 (SDA), R27.1; also elsewhere on the board
/biometric/IN_G1: IC11.38 (PC7); also elsewhere on the board
/biometric/IN_G2: IC11.25 (PC5); also elsewhere on the board
/biometric/IN_IR: IC11.28 (PB2); also elsewhere on the board
/biometric/IN_R: IC11.33 (PB12); also elsewhere on the board
/biometric/OUT_IR_EN: IC11.10 (PC2); also elsewhere on the board
/biometric/VOUT_IR: IC11.9 (PC1); also elsewhere on the board
/biometric/VOUT_RG: IC11.8 (PC0); also elsewhere on the board
/bluenrg/RESET_N: IC11.11 (PC3); also elsewhere on the board
/bluenrg/SPI_CS: IC11.15 (PA1); also elsewhere on the board
/bluenrg/SPI_IRQ: IC11.14 (PA0); also elsewhere on the board
/controller/BOOT0: IC11.60 (BOOT0), R48.2, R63.2
/controller/BTN_INT: IC11.2 (PC13), IC18.11 (~INT)
/controller/CS3_1: IC11.54 (PD2); also elsewhere on the board
/controller/DISP_EN: IC11.53 (PC12); also elsewhere on the board
/controller/DISP_IO_EN: IC11.58 (PB6); also elsewhere on the board
/controller/FLASH_CLK: IC10.18 (B2), IC12.6 (CLK)
/controller/FLASH_CS: IC10.20 (B1), IC12.1 (~CS)
/controller/FLASH_IO0: IC10.17 (B3), IC12.5 (DI_(IO0))
/controller/FLASH_IO1: IC10.16 (B4), IC12.2 (DO_(IO1))
/controller/FLASH_IO2: IC10.15 (B5), IC12.3 (~WP_(IO2))
/controller/FLASH_IO3: IC10.14 (B6), IC12.7 (~HOLD_(IO3))
/controller/GPS_RESET_N: IC11.20 (PA4); also elsewhere on the board
/controller/GPS_WAKEUP: IC11.24 (PC4); also elsewhere on the board
/controller/IO_FLASH_EN: IC10.10 (OE), IC11.21 (PA5), R29.2
/controller/NRST: IC11.7 (NRST), J1.12, R26.1, S1.3 (NO_1)
/controller/OSC32_IN: C61.1, IC11.3 (PC14-_OSC32_IN_(PC14)), Y3.1
/controller/OSC32_OUT: C62.1, IC11.4 (PC15-_OSC32_OUT_(PC15)), Y3.2
/controller/OTG_FS_BUS: IC11.42 (PA9), J2.1; also elsewhere on the board
/controller/OTG_FS_D+: IC11.45 (PA12), J2.3
/controller/OTG_FS_D-: IC11.44 (PA11), J2.2
/controller/OTG_FS_ID: IC11.43 (PA10), J2.4
/controller/OTG_FS_NOE: IC11.40 (PC9)
/controller/QUADSPI_BK1_IO0: IC10.4 (A3), IC11.27 (PB1)
/controller/QUADSPI_BK1_IO1: IC10.5 (A4), IC11.26 (PB0)
/controller/QUADSPI_BK1_IO2: IC10.6 (A5), IC11.23 (PA7)
/controller/QUADSPI_BK1_IO3: IC10.7 (A6), IC11.22 (PA6)
/controller/QUADSPI_CLK: IC10.3 (A2), IC11.29 (PB10)
/controller/QUADSPI_NCS: IC10.1 (A1), IC11.30 (PB11)
/controller/SPI3_CK: IC11.55 (PB3_(JTDO-TRACESWO)); also elsewhere on the board
/controller/SPI3_MISO: IC11.56 (PB4_(NJTRST))
/controller/SPI3_MOSI: IC11.57 (PB5); also elsewhere on the board
/controller/SWCLK: IC11.49 (PA14_(JTCK-SWCLK)), J1.6
/controller/SWDIO: IC11.46 (PA13_(JTMS-SWDIO)), J1.4
/controller/TIM2_CH1: IC11.50 (PA15_(JTDI)); also elsewhere on the board
/controller/USART2_RX: IC11.17 (PA3); also elsewhere on the board
/controller/USART2_TX: IC11.16 (PA2); also elsewhere on the board
/controller/USART3_RX: IC11.52 (PC11), J1.13
/controller/USART3_TX: IC11.51 (PC10), J1.14
/controller/VDD: C43.1, C44.1, C45.1, C46.1, C47.1, C48.1, C49.1, C50.1, C51.1, C53.1, C56.1, C58.1, IC10.2 (VCC(A)), IC11.1 (VBAT), IC11.13 (VDDA/VREF+), IC11.19 (VDD_1), IC11.32 (VDD_2), IC11.64 (VDD_3), IC18.14 (VDD), R26.2, R27.2, R28.2, R63.1, R65.1; also elsewhere on the board
GND: C43.2, C44.2, C45.2, C46.2, C47.2, C48.2, C49.2, C50.2, C51.2, C52.2, C53.2, C54.2, C55.2, C56.2, C57.2, C58.2, C59.2, C60.2, C61.2, C62.2, IC10.11 (GND_1), IC10.21 (GND_2), IC11.12 (VSSA/VREF-), IC11.18 (VSS_1), IC11.31 (VSS_2), IC11.47 (VSS_3), IC11.63 (VSS_4), IC12.4 (GND), IC12.9 (EP), IC18.6 (VSS_1), IC18.15 (A0), IC18.16 (A1), IC18.17 (VSS_2), J1.5, J1.7, J2.5, J2.MP1, J2.MP2, J2.MP3, J2.MP4, J2.MP5, J2.MP6, R29.1, R48.1, S1.1 (COM_1), S3.1, S4.1, S5.1, S6.1, S7.1; also elsewhere on the board
unnamed: IC18.2 (P0), R31.1, S4.3 (2)
unnamed: IC18.3 (P1), R30.1, S3.3 (2)
unnamed: IC18.7 (P4), R47.1, S7.3 (2)
unnamed: IC18.8 (P5), R33.1, S6.3 (2)
unnamed: IC18.9 (P6), R32.1, S5.3 (2)
unnamed: IC18.1 (~RESET), R65.2

Notes on the sheet:
Peak current 150 mA Typ.
Current consumption = 23.2 uA / MHz * 80 MHz = 1.9 mA
Max. current consumption = 35 mA

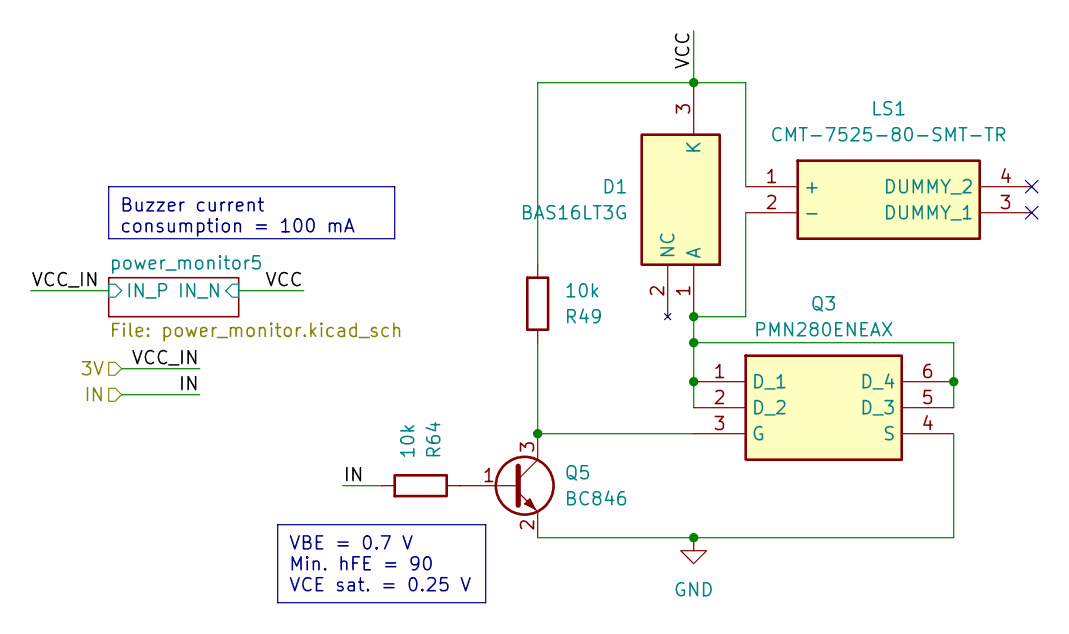
[picture p35: schematic audio.kicad_sch, Open Running Watch]

Parts:
D1: BAS16LT3G; SOT96P237X111-3N; Mouser Part Number 863-BAS16LT3G
LS1: CMT-7525-80-SMT-TR; CMT752580SMTTR; Mouser Part Number 490-CMT-7525-80SMTTR
Q3: PMN280ENEAX; Mouser Part Number 771-PMN280ENEAX
Q5: BC846; SOT-23; Manufacturer_Part_Number BC847BLT1G
R49, R64: 10k; R_0402_1005Metric; Manufacturer_Part_Number RC0402JR-0710KP

Connections:
/audio/IN: R64.2; also elsewhere on the board
/audio/VCC: D1.3 (K), LS1.1 (+), R49.2; also elsewhere on the board
GND: Q3.4 (S), Q5.2 (E); also elsewhere on the board
unnamed: D1.1 (A), LS1.2 (-), Q3.1 (D_1), Q3.2 (D_2), Q3.5 (D_3), Q3.6 (D_4)
unnamed: Q3.3 (G), Q5.3 (C), R49.1
unnamed: Q5.1 (B), R64.1

Notes on the sheet:
Buzzer current consumption = 100 mA
VBE = 0.7 V Min. hFE = 90 VCE sat. = 0.25 V

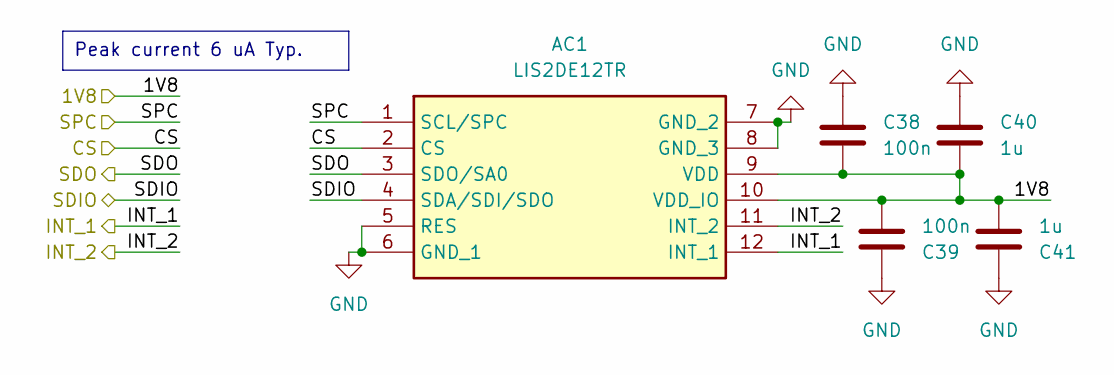
[picture p36: schematic accelerometer.kicad_sch, Open Running Watch]

Parts:
AC1: LIS2DE12TR; Mouser Part Number 511-LIS2DE12TR
C38, C39: 100n; C_0402_1005Metric; Manufacturer_Part_Number GRM155R71A104MA01D
C40, C41: 1u; C_0603_1608Metric; Manufacturer_Part_Number C0603C105K4RACTU

Connections:
/accelerometer/CS: AC1.2 (CS); also elsewhere on the board
/accelerometer/INT_1: AC1.12 (INT_1); also elsewhere on the board
/accelerometer/INT_2: AC1.11 (INT_2); also elsewhere on the board
/accelerometer/SDIO: AC1.4 (SDA/SDI/SDO); also elsewhere on the board
/accelerometer/SDO: AC1.3 (SDO/SA0); also elsewhere on the board
/accelerometer/SPC: AC1.1 (SCL/SPC); also elsewhere on the board
GND: AC1.5 (RES), AC1.6 (GND_1), AC1.7 (GND_2), AC1.8 (GND_3), C38.1, C39.1, C40.1, C41.1; also elsewhere on the board

Notes on the sheet:
Peak current 6 uA Typ.

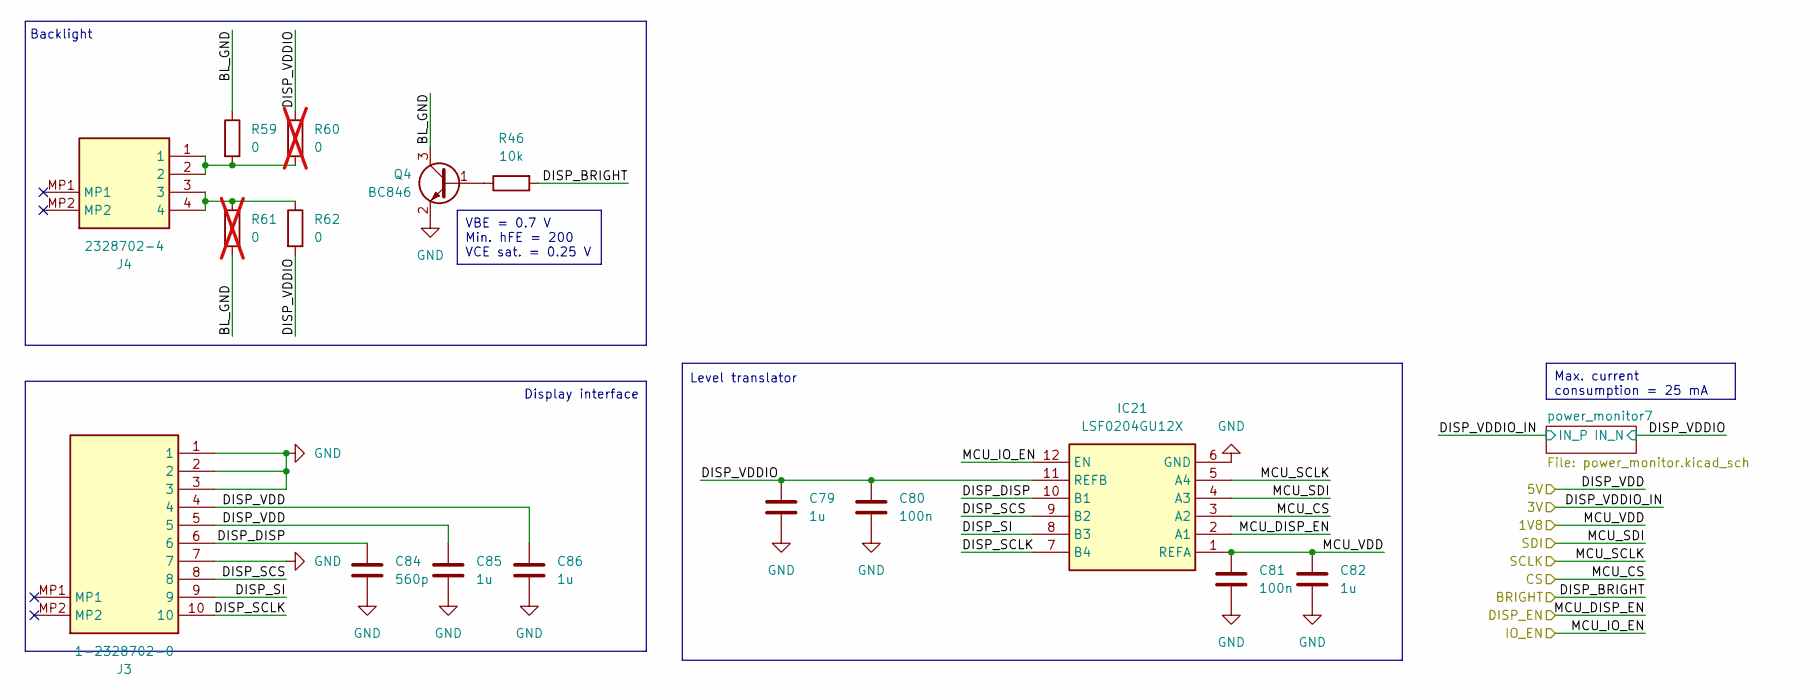
[picture p37: schematic mip_display.kicad_sch, Open Running Watch]

Parts:
C79, C82, C85, C86: 1u; C_0603_1608Metric; Manufacturer_Part_Number C0603C105K4RACTU
C80, C81: 100n; C_0402_1005Metric; Manufacturer_Part_Number GRM155R71A104MA01D
C84: 560p; C_0402_1005Metric; Manufacturer_Part_Number GRT1555C1H561FA02D
IC21: LSF0204GU12X; Mouser Part Number 771-LSF0204GU12X
J3: 1-2328702-0; 123287020; Mouser Part Number 571-1-2328702-0
J4: 2328702-4; 23287024; Mouser Part Number 571-2328702-4
Q4: BC846; SOT-23; Manufacturer_Part_Number BC847BLT1G
R46: 10k; R_0402_1005Metric; Manufacturer_Part_Number RC0402JR-0710KP
R59, R62: 0; R_0402_1005Metric_Pad0.72x0.64mm_HandSolder; Manufacturer_Part_Number AC0402JR-7D0RL
R60, R61: 0; R_0402_1005Metric_Pad0.72x0.64mm_HandSolder; Manufacturer_Part_Number AC0402JR-7D0RL; not fitted

Connections:
/controller/CS3_1: IC21.3 (A2); also elsewhere on the board
/controller/DISP_EN: IC21.2 (A1); also elsewhere on the board
/controller/DISP_IO_EN: IC21.12 (EN); also elsewhere on the board
/controller/SPI3_CK: IC21.5 (A4); also elsewhere on the board
/controller/SPI3_MOSI: IC21.4 (A3); also elsewhere on the board
/controller/TIM2_CH1: R46.2; also elsewhere on the board
/mip_display/BL_GND: Q4.3 (C), R59.1, R61.2
/mip_display/DISP_DISP: C84.1, IC21.10 (B1), J3.6
/mip_display/DISP_SCLK: IC21.7 (B4), J3.10
/mip_display/DISP_SCS: IC21.9 (B2), J3.8
/mip_display/DISP_SI: IC21.8 (B3), J3.9
/mip_display/DISP_VDD: C85.2, C86.2, J3.4, J3.5; also elsewhere on the board
/mip_display/DISP_VDDIO: C79.2, C80.2, IC21.11 (REFB), R60.1, R62.2; also elsewhere on the board
GND: C79.1, C80.1, C81.1, C82.1, C84.2, C85.1, C86.1, IC21.6 (GND), J3.1, J3.2, J3.3, J3.7, Q4.2 (E); also elsewhere on the board
unnamed: J4.1, J4.2, R59.2, R60.2
unnamed: J4.3, J4.4, R61.1, R62.1
unnamed: Q4.1 (B), R46.1

Notes on the sheet:
VBE = 0.7 V Min. hFE = 200 VCE sat. = 0.25 V
Max. current consumption = 25 mA
Level translator
Display interface
Backlight

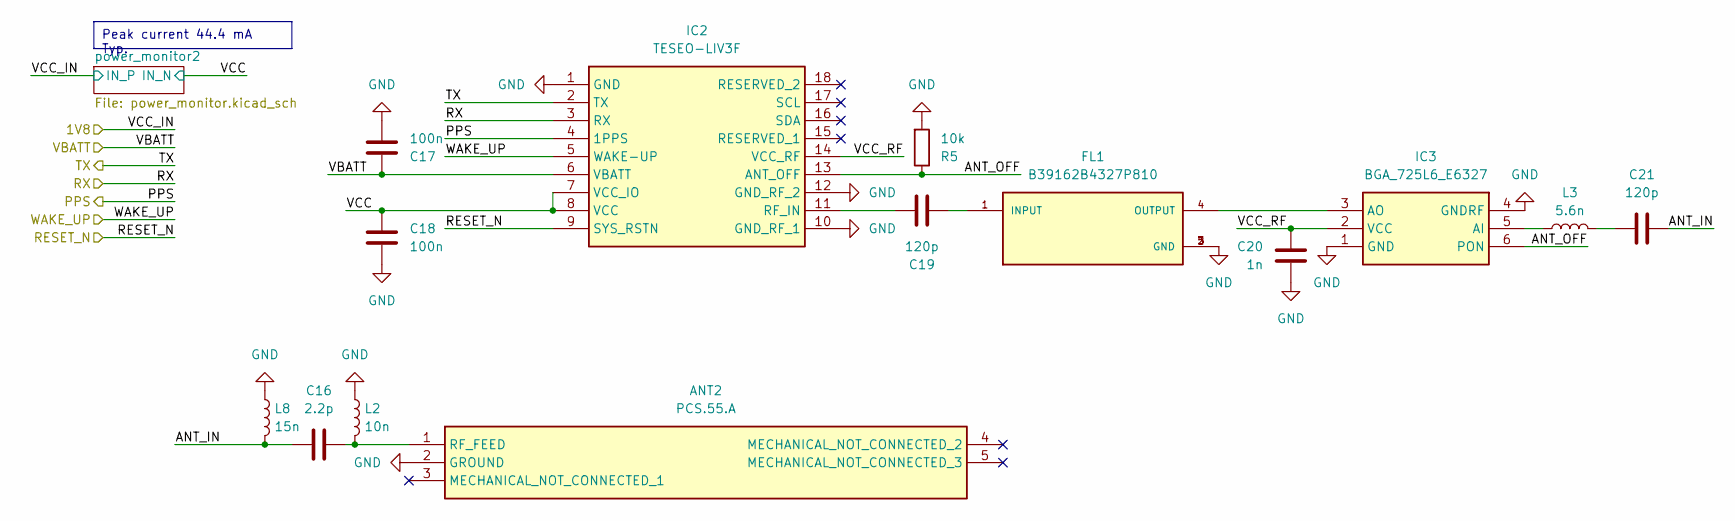
[picture p38: schematic gps.kicad_sch, Open Running Watch]

Parts:
ANT2: PCS.55.A; PCS55A; Mouser Part Number 960-PCS.55.A
C16: 2.2p; C_0402_1005Metric; Manufacturer_Part_Number GRM1555C1H2R2CA01D
C17, C18: 100n; C_0402_1005Metric; Manufacturer_Part_Number GRM155R71A104MA01D
C19, C21: 120p; C_0402_1005Metric; Manufacturer_Part_Number GCM1555C1H121JA16D
C20: 1n; C_0402_1005Metric; Manufacturer_Part_Number GCM155R71H102KA37D
FL1: B39162B4327P810; FIL_B39162B4327P810; Manufacturer_Part_Number B39162B4327P810
IC2: TESEO-LIV3F; SON110P970X1010X230-18N; Mouser Part Number 511-TESEO-LIV3F
IC3: BGA_725L6_E6327; BGA725L6E6327; Mouser Part Number 726-BGA725L6E6327
L2: 10n; L_0402_1005Metric; Manufacturer_Part_Number LQG15HS10NH02D
L3: 5.6n; L_0402_1005Metric; Manufacturer_Part_Number LQW15AN5N6G80D
L8: 15n; L_0402_1005Metric; Manufacturer_Part_Number LQG15HN15NG02D
R5: 10k; R_0402_1005Metric; Manufacturer_Part_Number RC0402JR-0710KP

Connections:
/controller/GPS_RESET_N: IC2.9 (SYS_RSTN); also elsewhere on the board
/controller/GPS_WAKEUP: IC2.5 (WAKE-UP); also elsewhere on the board
/controller/USART2_RX: IC2.2 (TX); also elsewhere on the board
/controller/USART2_TX: IC2.3 (RX); also elsewhere on the board
/gps/ANT_IN: C16.2, C21.2, L8.2
/gps/ANT_OFF: IC2.13 (ANT_OFF), IC3.6 (PON), R5.1
/gps/PPS: IC2.4 (1PPS)
/gps/VCC: C18.1, IC2.7 (VCC_IO), IC2.8 (VCC); also elsewhere on the board
/gps/VCC_RF: C20.1, IC2.14 (VCC_RF), IC3.2 (VCC)
GND: ANT2.2 (GROUND), C17.2, C18.2, C20.2, FL1.2 (GND), FL1.3 (GND), FL1.5 (GND), IC2.1 (GND), IC2.10 (GND_RF_1), IC2.12 (GND_RF_2), IC3.1 (GND), IC3.4 (GNDRF), L2.1, L8.1, R5.2; also elsewhere on the board
unnamed: ANT2.1 (RF_FEED), C16.1, L2.2
unnamed: C21.1, L3.2
unnamed: C19.2, FL1.1 (INPUT)
unnamed: FL1.4 (OUTPUT), IC3.3 (AO)
unnamed: C19.1, IC2.11 (RF_IN)
unnamed: IC3.5 (AI), L3.1

Notes on the sheet:
Peak current 44.4 mA Typ.

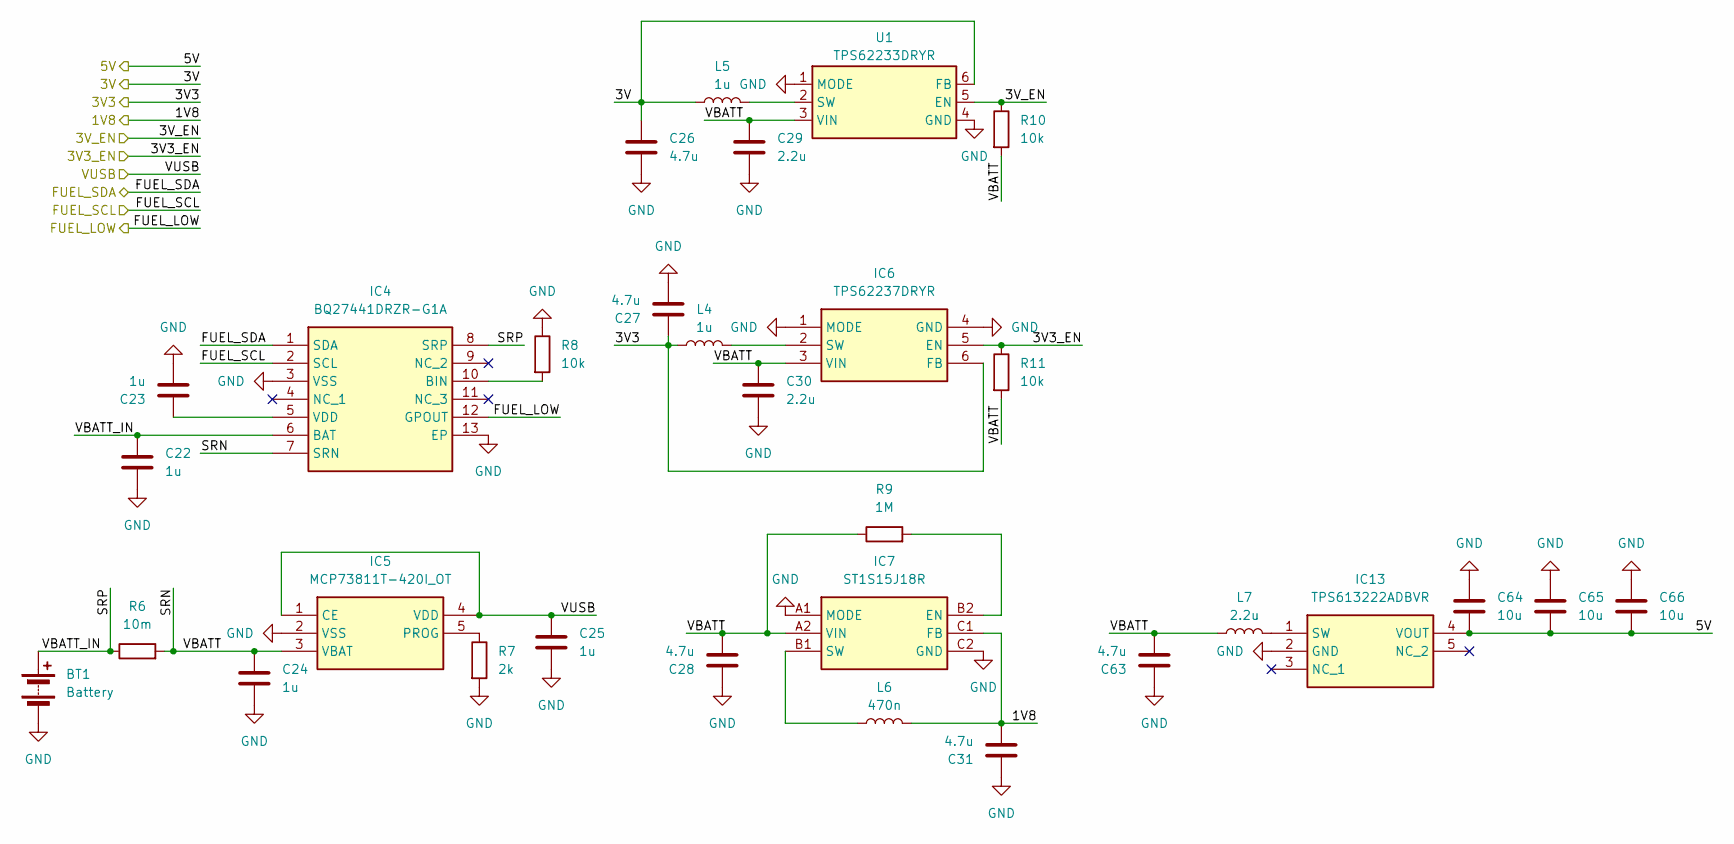
[picture p39: schematic power.kicad_sch, Open Running Watch]

Parts:
BT1: Battery; SolderWire-0.1sqmm_1x02_P3.6mm_D0.4mm_OD1mm
C22, C23, C24, C25: 1u; C_0603_1608Metric; Manufacturer_Part_Number C0603C105K4RACTU
C26, C27, C28, C31, C63: 4.7u; C_0402_1005Metric; Manufacturer_Part_Number GRM155R60J475ME87J
C29, C30: 2.2u; C_0402_1005Metric; Manufacturer_Part_Number GRM155R60J225ME95J
C64, C65, C66: 10u; C_0603_1608Metric; Manufacturer_Part_Number GRM188R60J106ME47J
IC4: BQ27441DRZR-G1A; BQ27441DRZRG1A; Mouser Part Number 595-BQ27441DRZR-G1A
IC5: MCP73811T-420I_OT; SOT95P270X145-5N; Mouser Part Number 579-MCP73811T-420IOT
IC6: TPS62237DRYR; Texas_USON-6_1x1.45mm_P0.5mm_SMD; Mouser Part Number 595-TPS62237DRYR
IC7: ST1S15J18R; BGA6C40P2X3_94X119X60; Mouser Part Number 511-ST1S15J18R
IC13: TPS613222ADBVR; SOT95P280X145-5N; Mouser Part Number 595-TPS613222ADBVR
L4, L5: 1u; L_1008_2520Metric; Manufacturer_Part_Number LQM2HPN1R0MJ0L
L6: 470n; L_0805_2012Metric; Manufacturer_Part_Number LQM21PNR47MC0D
L7: 2.2u; L_1008_2520Metric; Manufacturer_Part_Number DFE252012F-2R2M=P2
R6: 10m; R_1206_3216Metric; Manufacturer_Part_Number CRF1206-FZ-R010ELF
R7: 2k; R_0402_1005Metric; Manufacturer_Part_Number RC0402FR-132KL
R8, R10, R11: 10k; R_0402_1005Metric; Manufacturer_Part_Number RC0402JR-0710KP
R9: 1M; R_0402_1005Metric; Manufacturer_Part_Number RC0402JR-071ML
U1: TPS62233DRYR; Texas_USON-6_1x1.45mm_P0.5mm_SMD; Manufacturer_Part_Number TPS62233DRYR

Connections:
/audio/VCC_IN: C26.1, L5.1, U1.6 (FB); also elsewhere on the board
/barometer/SCL: IC4.2 (SCL); also elsewhere on the board
/barometer/SDA: IC4.1 (SDA); also elsewhere on the board
/controller/OTG_FS_BUS: C25.1, IC5.1 (CE), IC5.4 (VDD); also elsewhere on the board
/mip_display/DISP_VDD: C64.2, C65.2, C66.2, IC13.4 (VOUT); also elsewhere on the board
/power/3V3_EN: IC6.5 (EN), R11.1
/power/3V_EN: R10.1, U1.5 (EN)
/power/FUEL_LOW: IC4.12 (GPOUT)
/power/SRN: C24.1, C28.2, C29.1, C30.1, C63.2, IC4.7 (SRN), IC5.3 (VBAT), IC6.3 (VIN), IC7.A2 (VIN), L7.1, R6.2, R9.1, R10.2, R11.2, U1.3 (VIN)
/power/SRP: BT1.1 (+), C22.1, IC4.6 (BAT), IC4.8 (SRP), R6.1
GND: BT1.2 (-), C22.2, C23.2, C24.2, C25.2, C26.2, C27.2, C28.1, C29.2, C30.2, C31.1, C63.1, C64.1, C65.1, C66.1, IC4.3 (VSS), IC4.13 (EP), IC5.2 (VSS), IC6.1 (MODE), IC6.4 (GND), IC7.A1 (MODE), IC7.C2 (GND), IC13.2 (GND), R7.2, R8.1, U1.1 (MODE), U1.4 (GND); also elsewhere on the board
unnamed: IC4.10 (BIN), R8.2
unnamed: C23.1, IC4.5 (VDD)
unnamed: IC5.5 (PROG), R7.1
unnamed: IC6.2 (SW), L4.2
unnamed: IC7.B2 (EN), R9.2
unnamed: IC7.B1 (SW), L6.1
unnamed: IC13.1 (SW), L7.2
unnamed: L5.2, U1.2 (SW)
