fuad1502/open-running-watch-hw/open-running-watch.kicad_pcb

## KiCad design open-running-watch.kicad_pcb (continued)

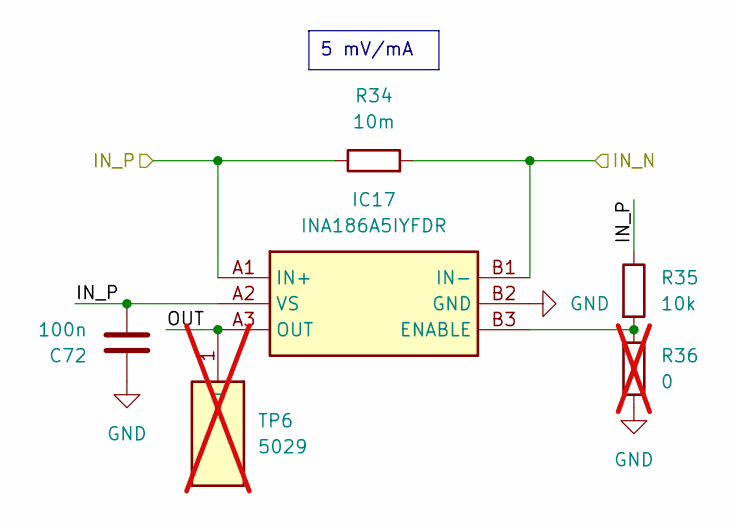
[picture p40: schematic power_monitor.kicad_sch, Open Running Watch]

Parts:
C72: 100n; C_0402_1005Metric; Manufacturer_Part_Number GRM155R71A104MA01D
IC17: INA186A5IYFDR; BGA6C40P3X2_117X76X40; Mouser Part Number 595-INA186A5IYFDR
R34: 10m; R_1206_3216Metric; Manufacturer_Part_Number CRF1206-FZ-R010ELF
R35: 10k; R_0402_1005Metric; Manufacturer_Part_Number RC0402JR-0710KP
R36: 0; R_0402_1005Metric_Pad0.72x0.64mm_HandSolder; Manufacturer_Part_Number AC0402JR-7D0RL; not fitted
TP6: 5029; Mouser Part Number 534-5029; not fitted

Connections:
GND: C72.1, IC17.B2 (GND), R36.2; also elsewhere on the board

Parts of its further copies:
C73, C74, C75, C77, C78, C83: 100n; C_0402_1005Metric; Manufacturer_Part_Number GRM155R71A104MA01D
IC14, IC15, IC16, IC19, IC20, IC22: INA186A5IYFDR; BGA6C40P3X2_117X76X40; Mouser Part Number 595-INA186A5IYFDR
R37, R40, R43, R50, R53, R56: 10m; R_1206_3216Metric; Manufacturer_Part_Number CRF1206-FZ-R010ELF
R38, R41, R44, R51, R54, R57: 10k; R_0402_1005Metric; Manufacturer_Part_Number RC0402JR-0710KP
R39, R42, R45, R52, R55, R58: 0; R_0402_1005Metric_Pad0.72x0.64mm_HandSolder; Manufacturer_Part_Number AC0402JR-7D0RL; not fitted
TP1, TP2, TP3, TP4, TP7, TP8: 5029; Mouser Part Number 534-5029; not fitted

Connections of its further copies:
/audio/VCC: IC19.B1 (IN-), R50.2; also elsewhere on the board
/audio/VCC_IN: C77.2, C83.2, IC19.A1 (IN+), IC19.A2 (VS), IC22.A1 (IN+), IC22.A2 (VS), R50.1, R51.1, R56.1, R57.1; also elsewhere on the board
/biometric/VCC: IC20.B1 (IN-), R53.2; also elsewhere on the board
/biometric/power_monitor6/OUT: IC20.A3 (OUT), TP7.1
/controller/VDD: IC15.B1 (IN-), R37.2; also elsewhere on the board
/controller/power_monitor1/OUT: IC15.A3 (OUT), TP2.1
/controller/power_monitor/OUT: IC14.A3 (OUT), TP1.1
/gps/VCC: IC16.B1 (IN-), R40.2; also elsewhere on the board
/gps/power_monitor2/OUT: IC16.A3 (OUT), TP3.1
/mip_display/DISP_VDDIO: IC22.B1 (IN-), R56.2; also elsewhere on the board
/mip_display/power_monitor7/OUT: IC22.A3 (OUT), TP8.1
GND: C73.1, C74.1, C75.1, C77.1, C78.1, C83.1, IC14.B2 (GND), IC15.B2 (GND), IC16.B2 (GND), IC19.B2 (GND), IC20.B2 (GND), IC22.B2 (GND), R39.2, R42.2, R45.2, R52.2, R55.2, R58.2; also elsewhere on the board
unnamed: IC15.B3 (ENABLE), R38.2, R39.1
unnamed: IC16.B3 (ENABLE), R41.2, R42.1
unnamed: IC19.B3 (ENABLE), R51.2, R52.1
unnamed: IC20.B3 (ENABLE), R54.2, R55.1
unnamed: IC22.B3 (ENABLE), R57.2, R58.1

Notes on the sheet:
5 mV/mA

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
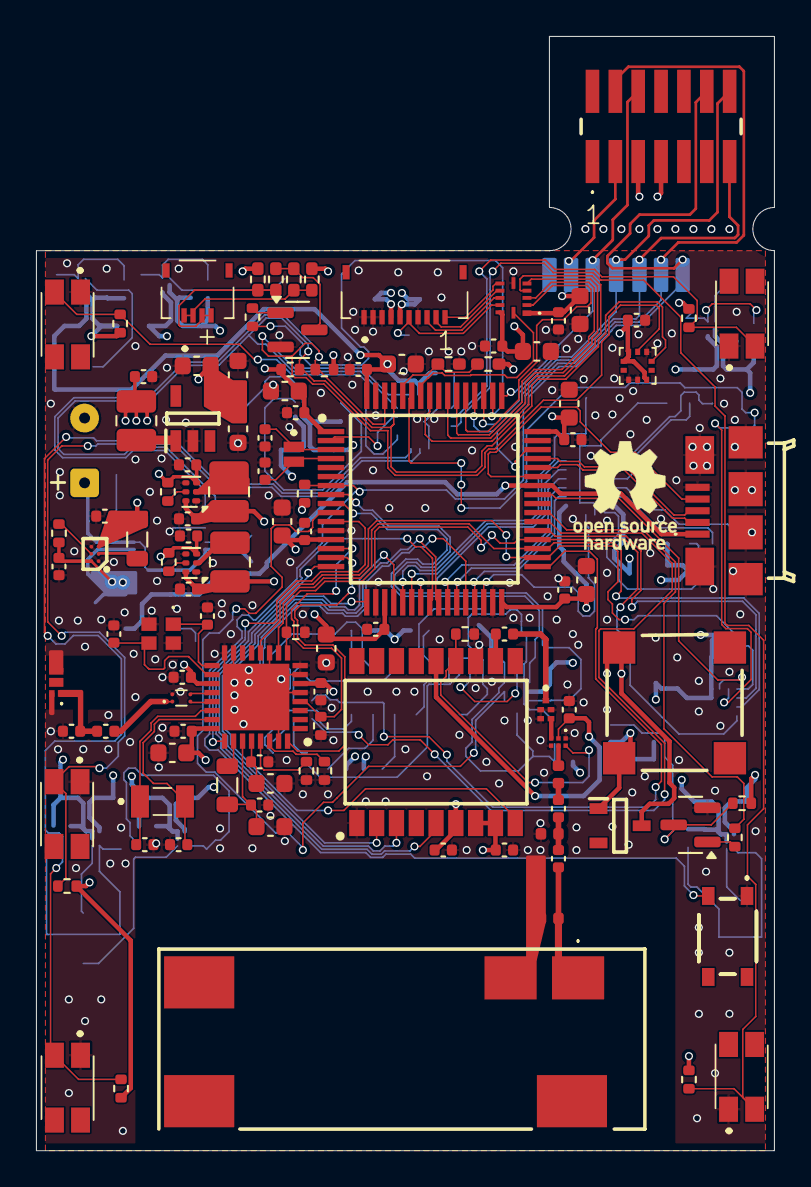
[picture p41: board open-running-watch.kicad_pcb from above]

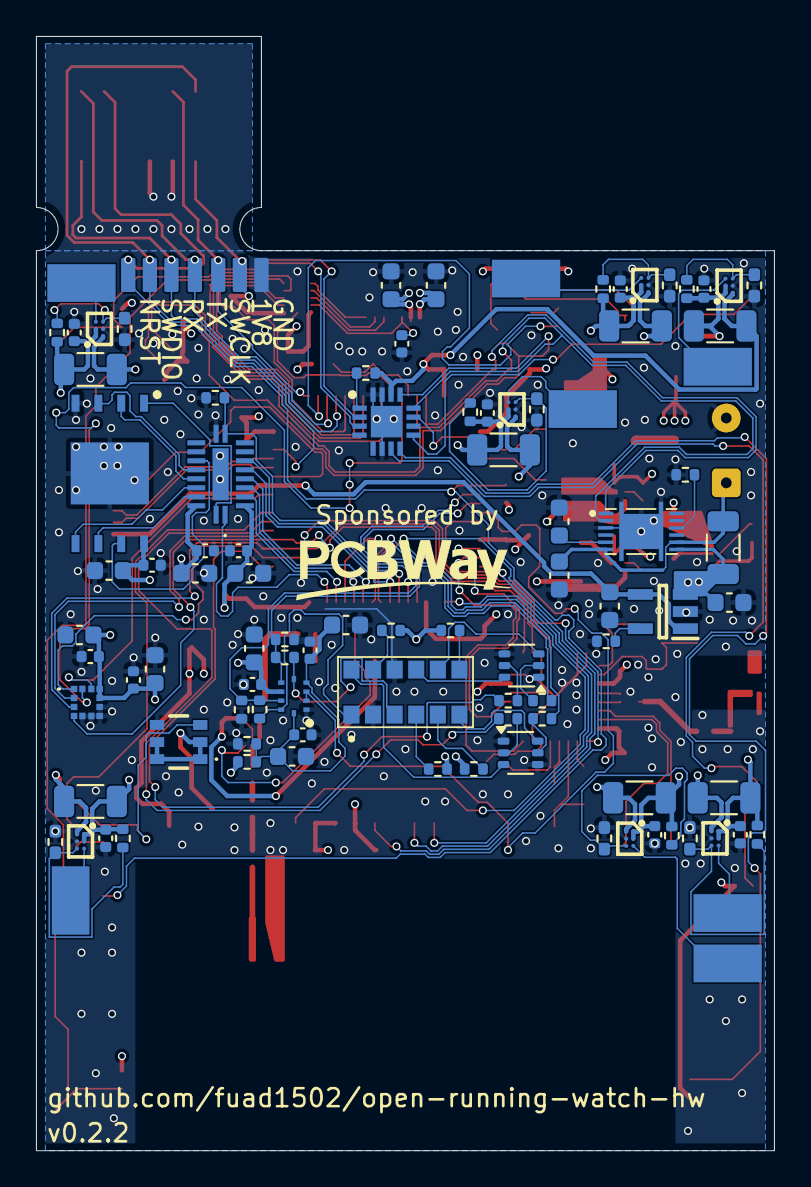
[picture p42: board open-running-watch.kicad_pcb from below]

Board: 4 copper layers, 41.0 x 61.9 mm, 210 parts (96 on the bottom side), 147 nets.

Other parts of the board:
LOGO1: OSHW-Logo_5.7x6mm_SilkScreen
