fuad1502/open-running-watch-hw/(commit log)

2024-04-12 Initial commit: finished first pass of schematic; Still need to resolve unconnected pins; Added all models
    [10118192-0001LF.stp, 20021121-00014T4LF.stp, 5029.stp, 505110-1492.stp, B39162B4327P810.step, BALF-NRG-02D3.stp, BAS16LT3G.stp, BC817-25-QVL.stp]
2024-04-12 Add company name (using github URL), date, and change revision number to all schematic pages
    [accelerometer.kicad_sch, audio.kicad_sch, barometer.kicad_sch, biometric.kicad_sch, bluenrg.kicad_sch, controller.kicad_sch, display.kicad_sch, gps.kicad_sch]
2024-04-13 Changed display to 12616-06 Sharp MIP display with Azumo backlight
    [1-2328702-0.stp, 12616-06_T3_prelim_02-04-2021.STEP, 2328702-4.stp, controller.kicad_sch, mip_display.kicad_sch, open-running-watch.kicad_sch, power_monitor.kicad_sch]
2024-04-13 Add 5V boost switching regulator
    [TPS613222ADBVR.stp, open-running-watch.kicad_sch, power.kicad_sch]
2024-04-13 Changed to smaller tactile switch
    [EVQ-P7J01P.stp, controller.kicad_sch, power.kicad_sch]
2024-04-13 Changed hand soldered footprints to normal footprints
    [accelerometer.kicad_sch, audio.kicad_sch, barometer.kicad_sch, biometric.kicad_sch, bluenrg.kicad_sch, controller.kicad_sch, gps.kicad_sch, mip_display.kicad_sch]
2024-04-14 Setup technology stackup and rules
    [open-running-watch.kicad_pcb]
2024-04-14 Changed GNSS antenna matching to world wide setting
    [gps.kicad_sch]
2024-04-14 Add RF and Power net classes to schematic nets
    [bluenrg.kicad_sch, controller.kicad_sch, gps.kicad_sch, open-running-watch.kicad_pcb, power.kicad_sch, power_monitor.kicad_sch]
2024-04-14 Place all components to PCB; Defined board layout
    [open-running-watch.kicad_pcb]
2024-04-16 Create symbol and footprint for the display to guide display interface placement
2024-04-16 Changed regulator footprint to KiCad provided one
    [power.kicad_sch]
2024-04-16 Remove BOOT0 switch to 0 ohm resistors
    [controller.kicad_sch]
2024-04-16 Remove RF netclass from a net in gps sheet; Monitor DISP_VDDIO instead of DISP_VDD; Correct constraints
    [gps.kicad_sch, mip_display.kicad_sch]
2024-04-16 Finished component placement and component grouping wirings
    [open-running-watch.kicad_pcb]
2024-04-17 Finished hardware design
    [20021121-00014T4LF--3DModel-STEP-56544.STEP, PCAL9538ABSHP.stp, controller.kicad_sch, mip_display.kicad_sch, open-running-watch.kicad_pcb]
2024-04-17 Remove additional spaces in Manufacturer_Part_Number field
    [accelerometer.kicad_sch, audio.kicad_sch, barometer.kicad_sch, biometric.kicad_sch, bluenrg.kicad_sch, controller.kicad_sch, gps.kicad_sch, mip_display.kicad_sch]
2024-04-17 Add NC to IO expander pins
    [controller.kicad_sch]
2024-04-17 Pulled in symbol attribute changes from schematic to PCB
    [open-running-watch.kicad_pcb]
2024-04-17 Changed battery connection footprint
    [open-running-watch.kicad_pcb, power.kicad_sch]
2024-04-17 Change GitHub CI to use KiCad 8 container
2024-05-03 Added 'sponsored by PCBWay' silkscreen
    [open-running-watch.kicad_pcb]
2024-05-13 Newline added at the end of all schematics due to newer KiCad/Ubuntu version
    [accelerometer.kicad_sch, barometer.kicad_sch, bluenrg.kicad_sch, gps.kicad_sch, open-running-watch.kicad_sch, power.kicad_sch, power_monitor.kicad_sch]
2024-05-13 Added NMOS transistor to models
    [PMN280ENEAX.stp]
2024-05-13 Changed transistor used in display backlight switch
    [mip_display.kicad_sch]
2024-05-13 Use NPN NMOS pair to switch the piezo on and off, to support higher current handling
    [audio.kicad_sch]
2024-05-13 Connect photodetector cathode instead of anode to amplifier input
    [biometric.kicad_sch]
2024-05-13 Add pull up to IO expander reset input; Corrected MISO/MOSI connection to hierarchical pin; Made USB data line as a differential line
    [controller.kicad_sch]
2024-05-13 Bumped schematic version to 0.1.1 and updated issue date
    [accelerometer.kicad_sch, audio.kicad_sch, barometer.kicad_sch, biometric.kicad_sch, bluenrg.kicad_sch, controller.kicad_sch, gps.kicad_sch, mip_display.kicad_sch]
2024-05-13 Updated PCB to reflect schematic changes since v0.1.0
    [open-running-watch.kicad_pcb]
2024-05-13 Bumped PCB version number to 0.1.1 and updated issue date
    [open-running-watch.kicad_pcb]
2024-05-13 Set 'do not populate' on power monitor probe point
    [power_monitor.kicad_sch]
2024-05-13 Create an opening in the bottom plane solder mask to allow connection to ground
    [open-running-watch.kicad_pcb]
2024-05-13 Narrow down solder mask opening and just position to minimize risk of electrical short
    [open-running-watch.kicad_pcb]
2024-05-13 Change version to 0.2.1; The previous release should've increased the minor version number
    [accelerometer.kicad_sch, audio.kicad_sch, barometer.kicad_sch, biometric.kicad_sch, bluenrg.kicad_sch, controller.kicad_sch, gps.kicad_sch, mip_display.kicad_sch]
2024-05-13 Reflect DNP in schematic to PCB
    [open-running-watch.kicad_pcb]
2024-05-13 Bump version to v0.2.2
    [accelerometer.kicad_sch, audio.kicad_sch, barometer.kicad_sch, biometric.kicad_sch, bluenrg.kicad_sch, controller.kicad_sch, gps.kicad_sch, mip_display.kicad_sch]
